analuhaas/ext-board/figures/image21.png

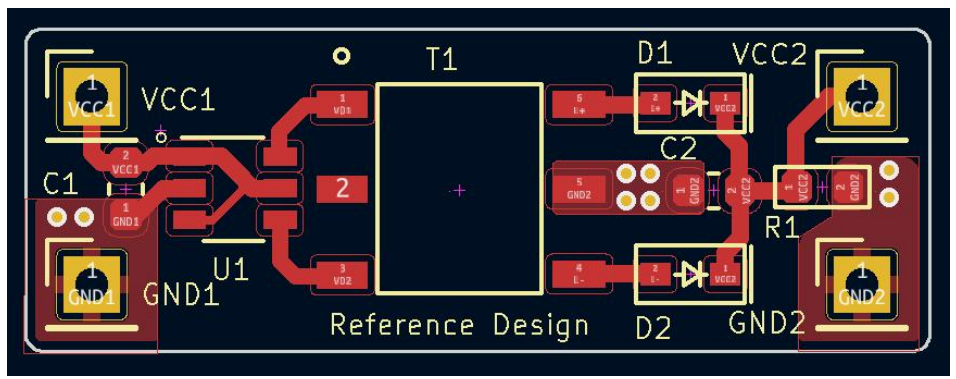
figures/image21.png
