analuhaas/ext-board/figures/image6.png

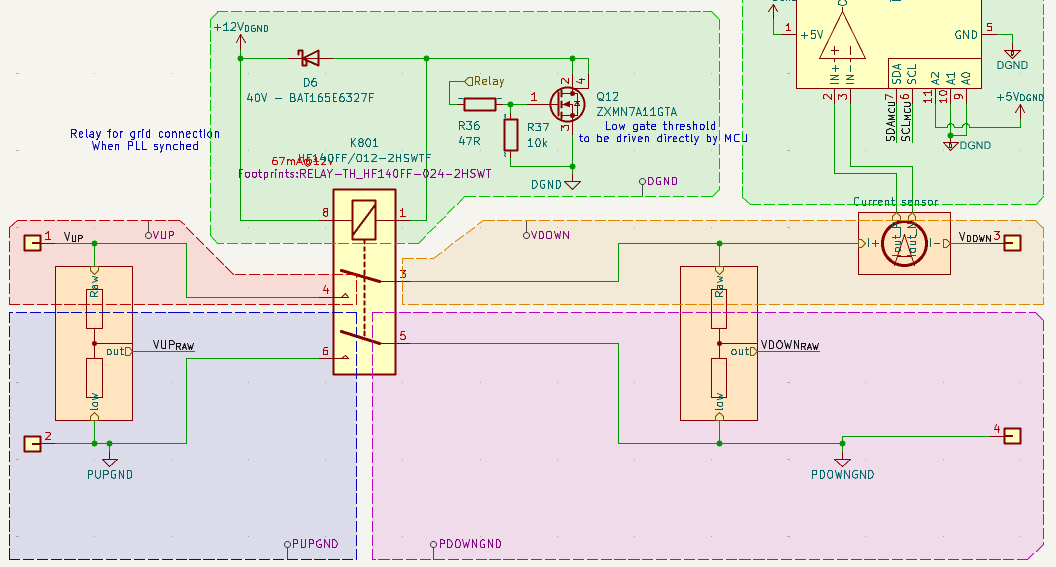
figures/image6.png
