analuhaas/ext-board/figures/image7.png

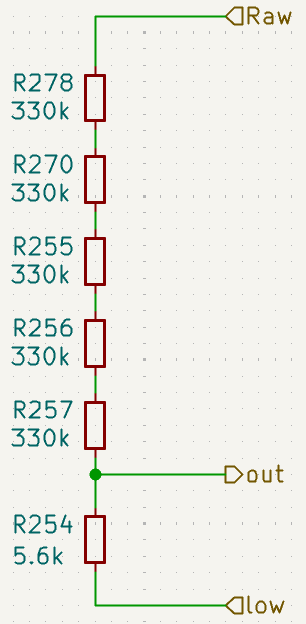
figures/image7.png
