analuhaas/ext-board/figures/image10.png

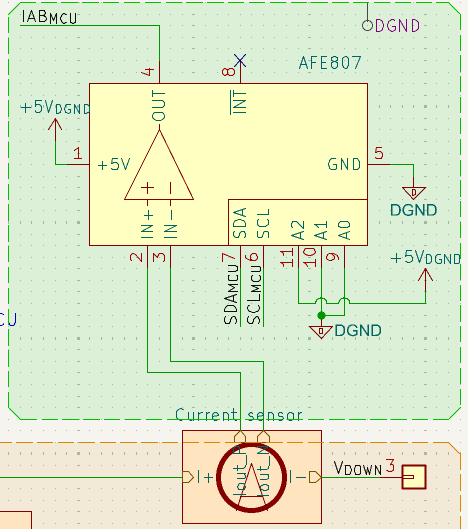
figures/image10.png
