analuhaas/ext-board/figures/image12.png

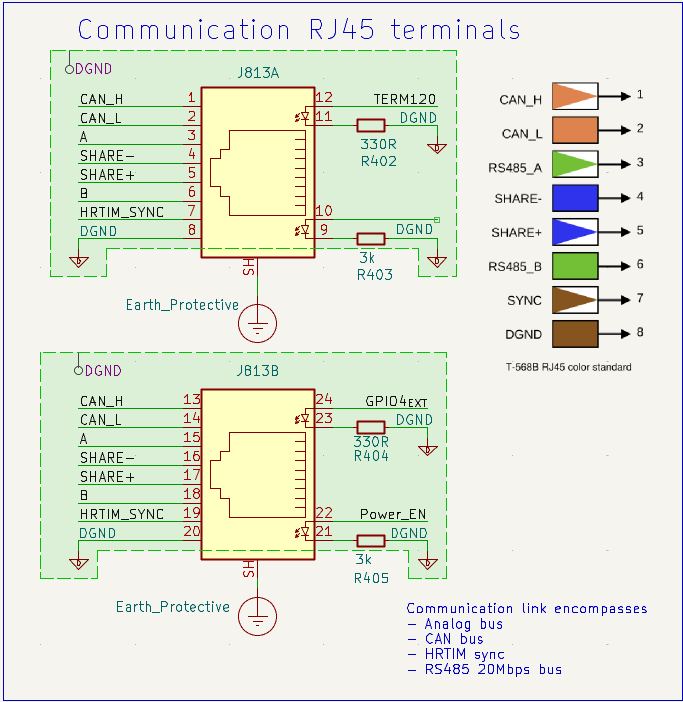
figures/image12.png
