analuhaas/ext-board/figures/image16.png

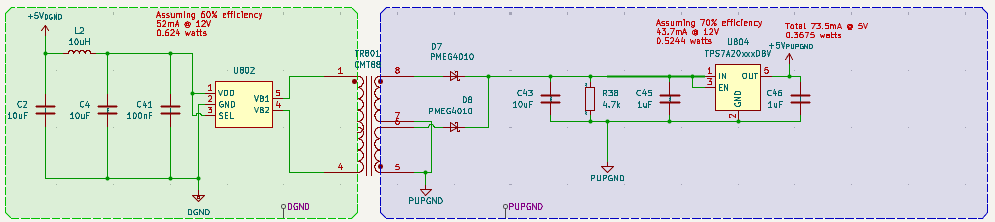
figures/image16.png
