analuhaas/ext-board/figures/image19.png

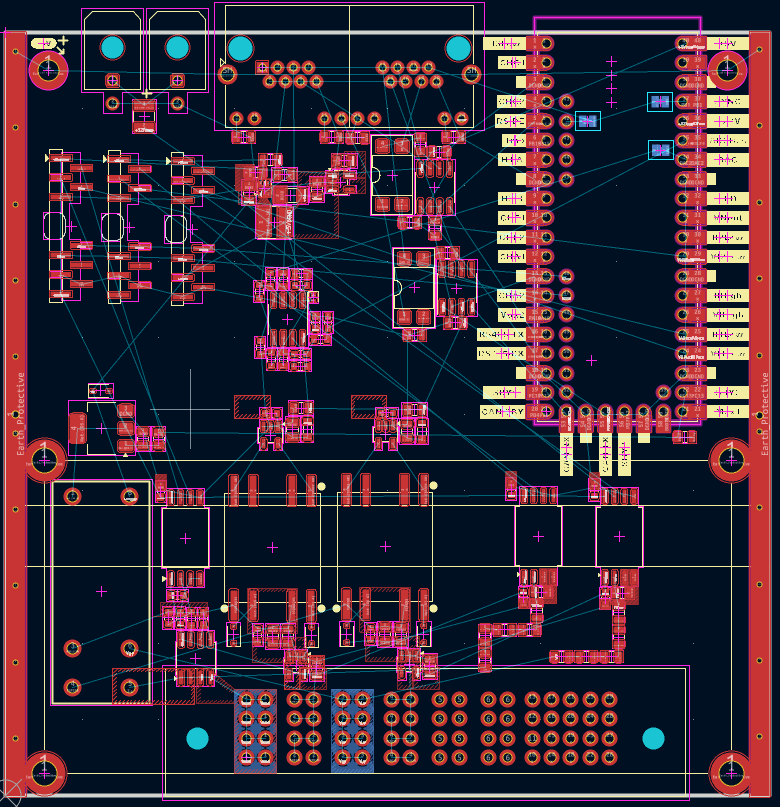
figures/image19.png
