analuhaas/ext-board/figures/image20.png

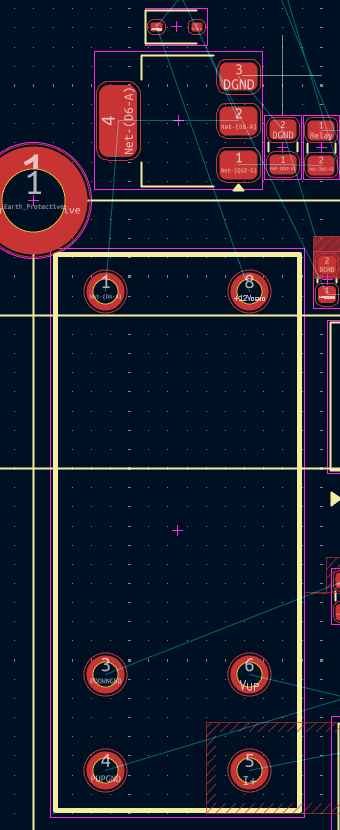
figures/image20.png
