analuhaas/ext-board/figures/image22.png

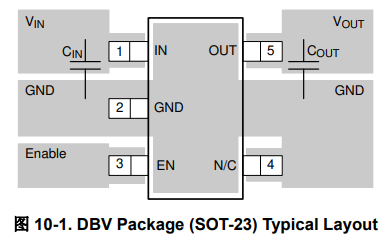
figures/image22.png
