analuhaas/ext-board/figures/image24.png

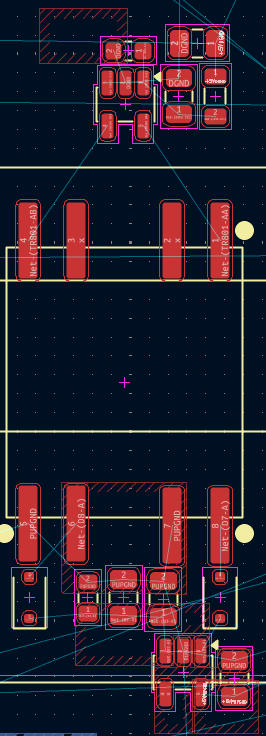
figures/image24.png
