analuhaas/ext-board/figures/image26.png

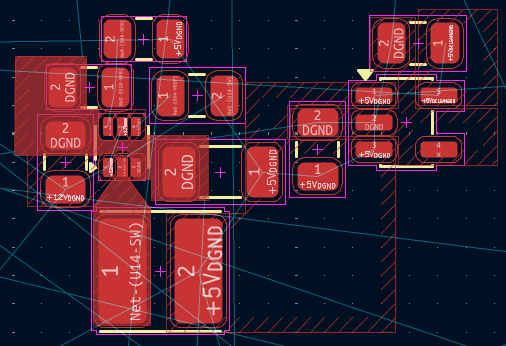
figures/image26.png
