analuhaas/ext-board/figures/image27.png

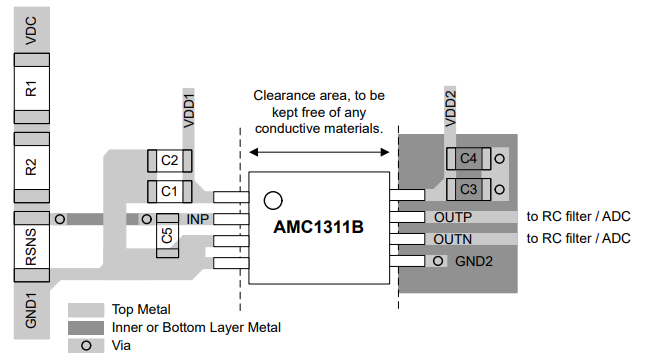
figures/image27.png
