analuhaas/ext-board/figures/image28.png

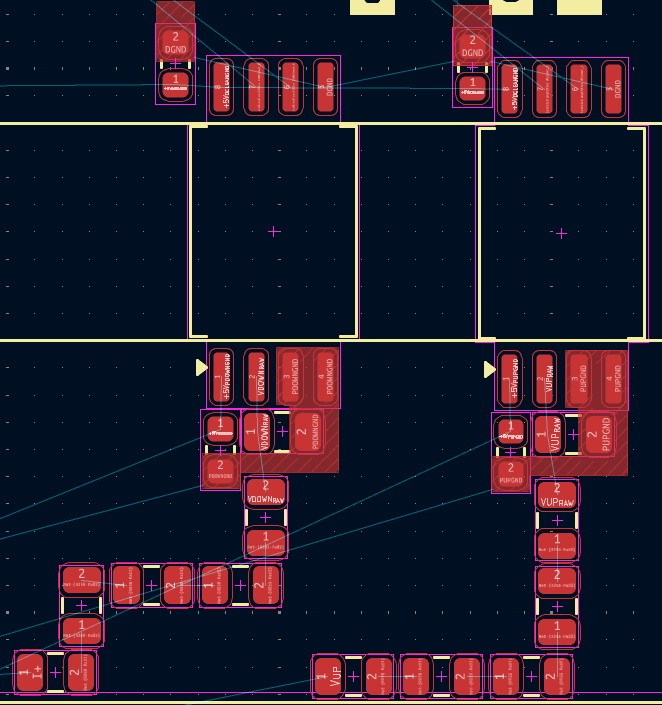
figures/image28.png
