analuhaas/ext-board/figures/image29.png

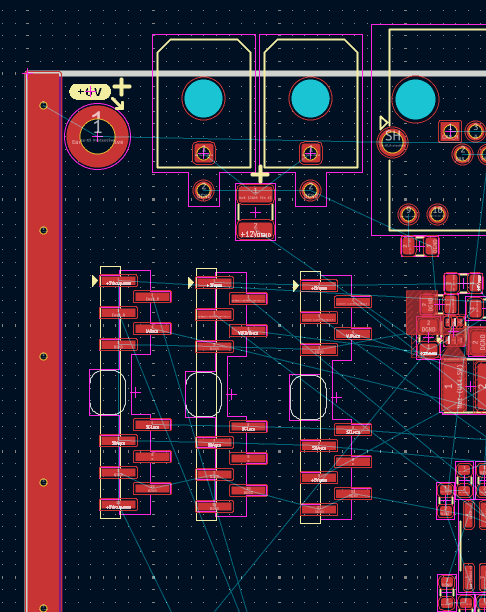
figures/image29.png
