analuhaas/ext-board/figures/image210.png

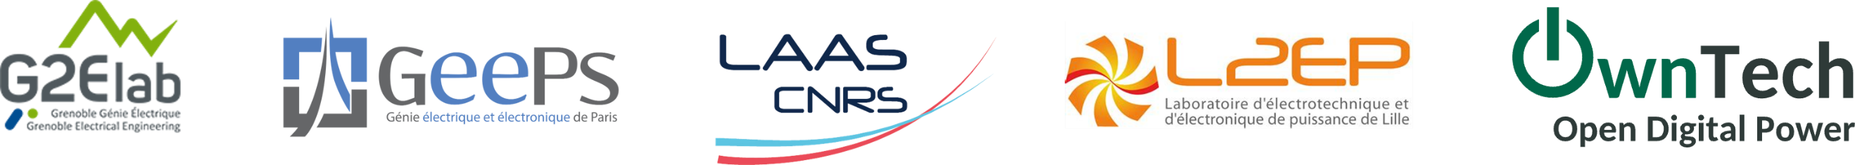
figures/image210.png
