analuhaas/ext-board/Schematic_Netlist_BOM/ext_board.csv

Reference | Value | Footprint | LCSC
C2,C3,C4,C5,C43,C44,C51 | 10uF | Capacitor_SMD:C_0805_2012Metric | C440198
C41,C42,C205,C206,C211,C212,C233,C234,C401,C410,C413,C492 | 100nF | Capacitor_SMD:C_0603_1608Metric | C14663
C45,C46,C47,C48,C49,C50 | 1uF | Capacitor_SMD:C_0805_2012Metric | C426085
C52 | 100nF | Capacitor_SMD:C_0805_2012Metric | C49678
C53 | 47uF | Capacitor_SMD:C_1206_3216Metric | C96123
C411,C412 | 20pF | Capacitor_SMD:C_0603_1608Metric | C1648
C470 | 10nF | Capacitor_SMD:C_0603_1608Metric | C1589
C493 | 1nF | Capacitor_SMD:C_0603_1608Metric | C1588
D6 | 40V - BAT165E6327F | Diode_SMD:D_SOD-323 | C42411276
D7,D8,D9,D10 | PMEG4010ESBYL | Diode_SMD:D_SOD-882 | C478156
D403 | BAS40DB | Diode_SMD:D_SOD-882 | C3000407
F402 | SMD1210-035-16V | Fuse:Fuse_1210_3225Metric | C70092
J405,J406 | HC-MX3.0-2*1AW | Footprints:Molex_Micro-Fit_3.0_43045-0200_2x01_P3.00mm_Horizontal | C3294382
J813 | RJ45_LED_Shielded_x2 | Footprints:RJ45_Amphenol_RJHSE538X-02 | C2902697
J819,J820,J821 |  | Footprints:PinSocket_1x05_P1.27mm_Vertical_SMD_Pin1Left | C46061714
J825,J826,J827 |  | Footprints:PinSocket_1x06_P1.27mm_Vertical_SMD_Pin1Right | C46061715
K801 | HF140FF/012-2HSWTF | Footprints:RELAY-TH_HF140FF-024-2HSWT | C5322766
L2,L3 | 10uH | Inductor_SMD:L_0805_2012Metric | C88173
L5 | 4.7uH - 80mR | Inductor_SMD:L_Cenker_CKCS4020 | C3002596
Q12 | ZXMN7A11GTA | Package_TO_SOT_SMD:SOT-223 | C460277
R36 | 47R | Resistor_SMD:R_0805_2012Metric | C17714
R37 | 10k | Resistor_SMD:R_0805_2012Metric | C17414
R38,R58,R412,R413,R414,R415,R416,R417,R418,R419,R428,R431,R432 | 4.7k | Resistor_SMD:R_0603_1608Metric | C23162
R55 | 120R | Footprints:R_0805_2012Metric | C17437
R56 | 56k | Footprints:R_0805_2012Metric | C17756
R57 | 10k | Footprints:R_0805_2012Metric | C17414
R249,R254 | 5.6k | Footprints:R_0805_2012Metric
R250,R251,R252,R255,R256,R257,R258,R269,R277,R278 | 330k | Footprints:R_0805_2012Metric | C17629
R259,R260,R261,R262,R279 | 330k | Resistor_SMD:R_1206_3216Metric | C104773
R280 | 15k | Resistor_SMD:R_0603_1608Metric | C22809
R281 | 10k | Resistor_SMD:R_0603_1608Metric | C25804
R401,R410,R470 | 120R | Resistor_SMD:R_0603_1608Metric | C22787
R402,R403,R404,R405 | 330R | Footprints:R_0805_2012Metric | C17630
R406,R407 | 680R | Resistor_SMD:R_0603_1608Metric | C23228
TR801,TR802 | CMT8830U | Footprints:CMT88F0U | C37648312
U14 | TPS562202 | Package_TO_SOT_SMD:SOT-563 | C2877547
U205,U207,U211 | AMC1311BDWVR | Package_SO:SOIC-8_7.5x5.85mm_P1.27mm | C783598
U402 | CA-IF1051S | Footprints:SOIC-8_3.9x4.9mm_P1.27mm | C5121951
U405 | CA-IF4850HS | Package_SO:SOIC-8_3.9x4.9mm_P1.27mm | C7422579
U406 | MCP6487T-E/SN | Package_SO:SOIC-8_3.9x4.9mm_P1.27mm | C5224810
U801 | ACS724LLCTR-50AB-T-JSM | Package_SO:SOIC-8_3.9x4.9mm_P1.27mm | C20606860
U802,U803 | CMP6503S | Package_TO_SOT_SMD:SOT-23-5 | C47117012
U804,U805,U806 | TPS7A20xxxDBV | Package_TO_SOT_SMD:SOT-23-5 | C2864504
U809 |  | Footprints:PwrBlade51722-106020
U820,U821 | GAQY221S | Package_SO:SOP-4_3.8x4.1mm_P2.54mm | C7435105
