analuhaas/ext-board/figures/image_wiring_Dfeed.png

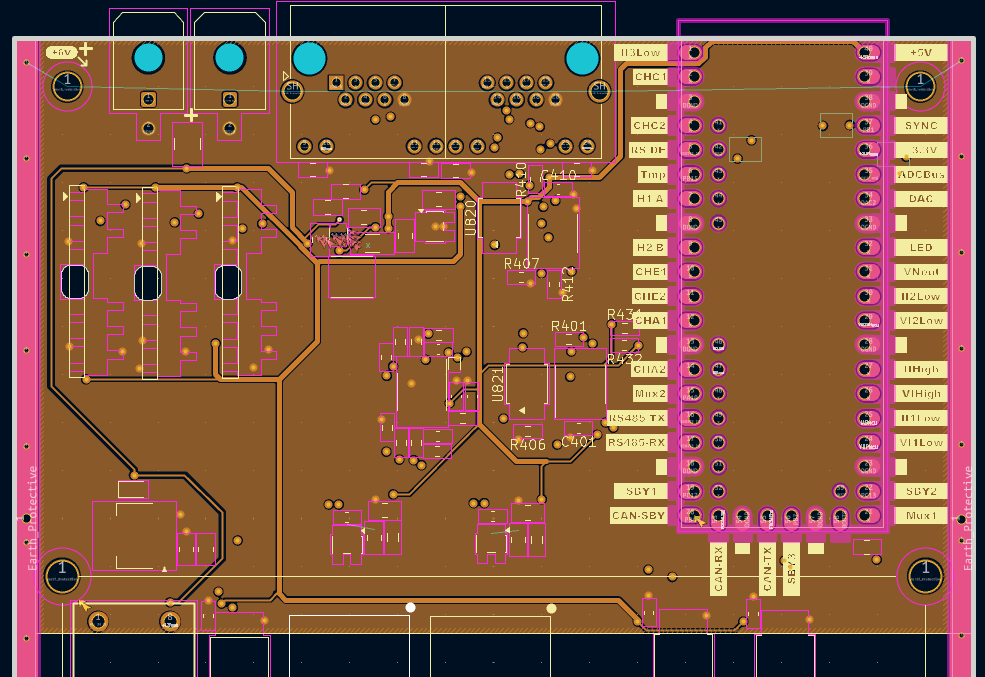
figures/image_wiring_Dfeed.png
