analuhaas/ext-board/figures/image_wiring_IsensorRelay.png

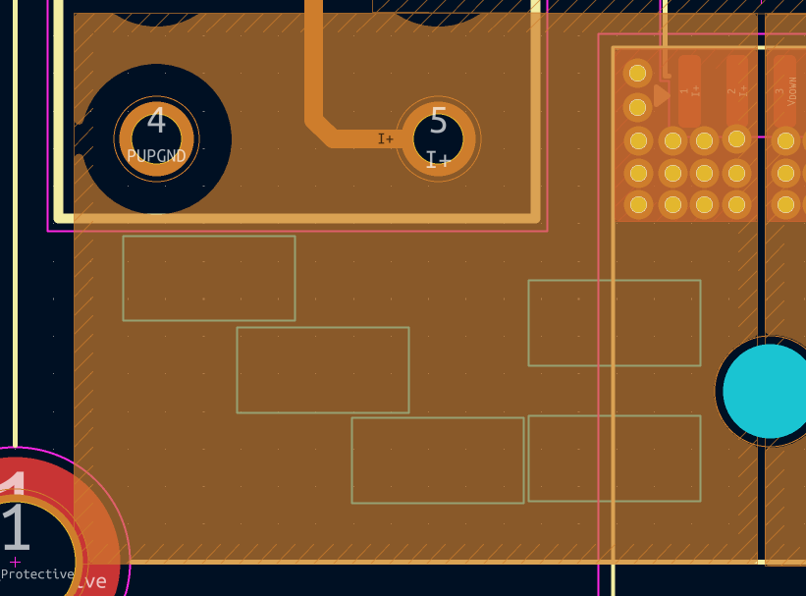
figures/image_wiring_IsensorRelay.png
