analuhaas/ext-board/figures/image_wiring_Pcircuit.png

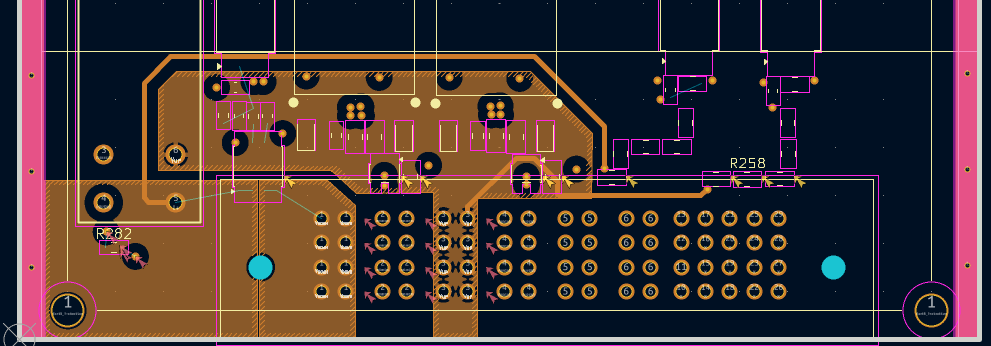
figures/image_wiring_Pcircuit.png
