analuhaas/ext-board/figures/image_wiring_Pfeed.png

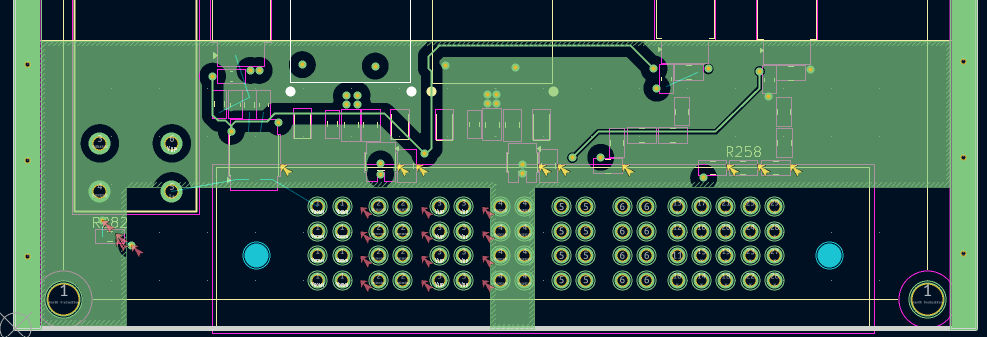
figures/image_wiring_Pfeed.png
