analuhaas/ext-board/Schematic_Netlist_BOM/ext_board.pdf

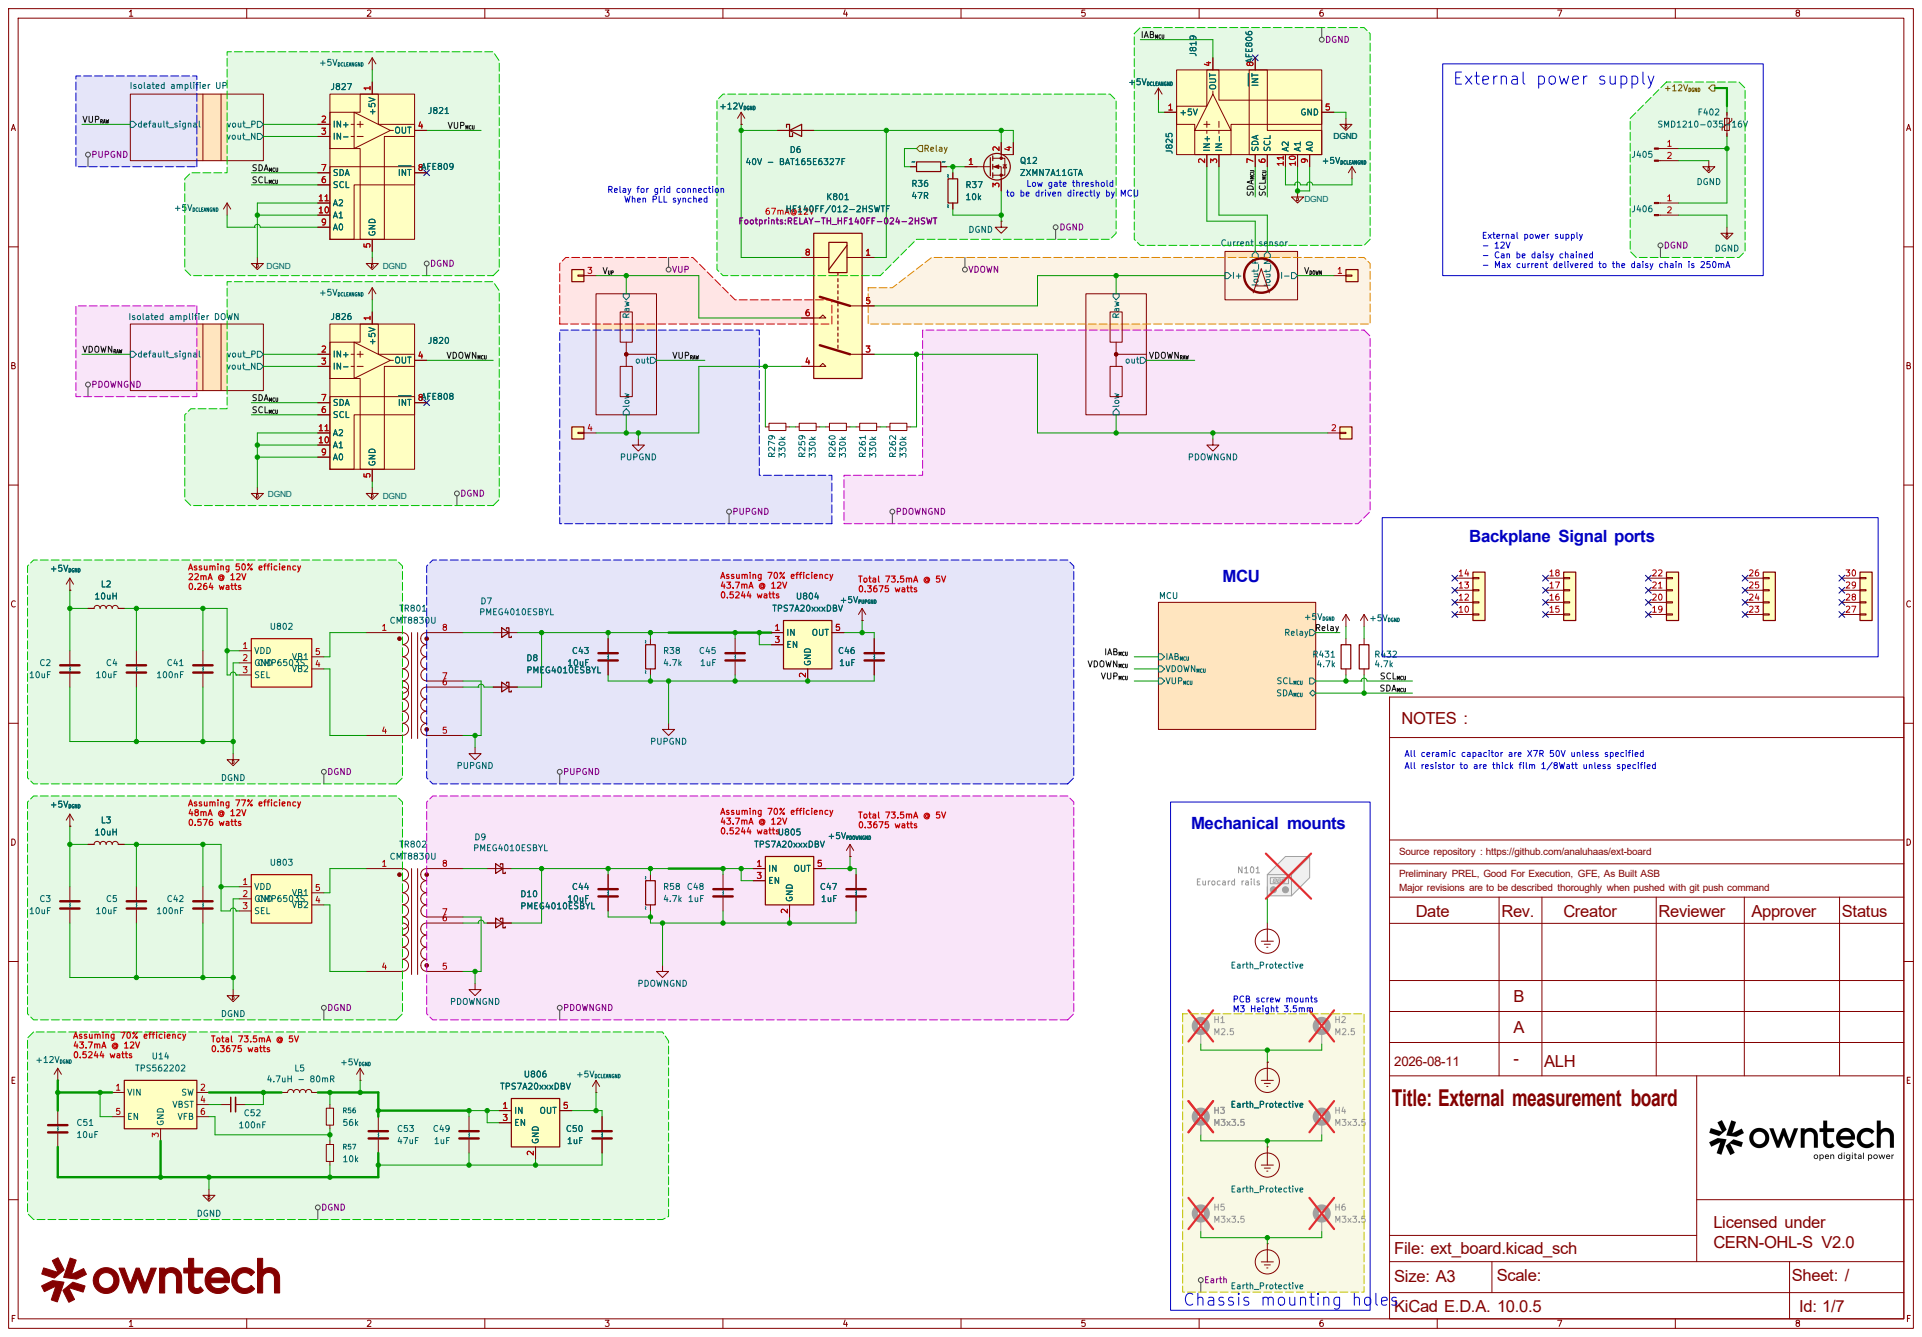
[picture p20: page 1]

3 OUT 4 GND 5 J825 SCL 6 SDA 7 INT 8 A0

Low gate threshold
to be driven directly by MCU

Relay for grid connection When PLL synched

Source repository : https://github.com/analuhaas/ext-board low out Raw

IABMCU VDOWNMCU VUPMCU MCU

All ceramic capacitor are X7R 50V unless specified U806

All resistor to are thick film 1/8Watt unless specified
Earth_Protective Earth_Protective N101

Major revisions are to be described thoroughly when pushed with git push command Preliminary PREL, Good For Execution, GFE, As Built ASB

Earth_Protective

2026-08-11 | - | ALH

Title: External measurement board | Licensed under CERN-OHL-S V2.0

Size: A3 | Sheet: / | F Scale:
KiCad E.D.A. 10.0.5 | Id: 1/7

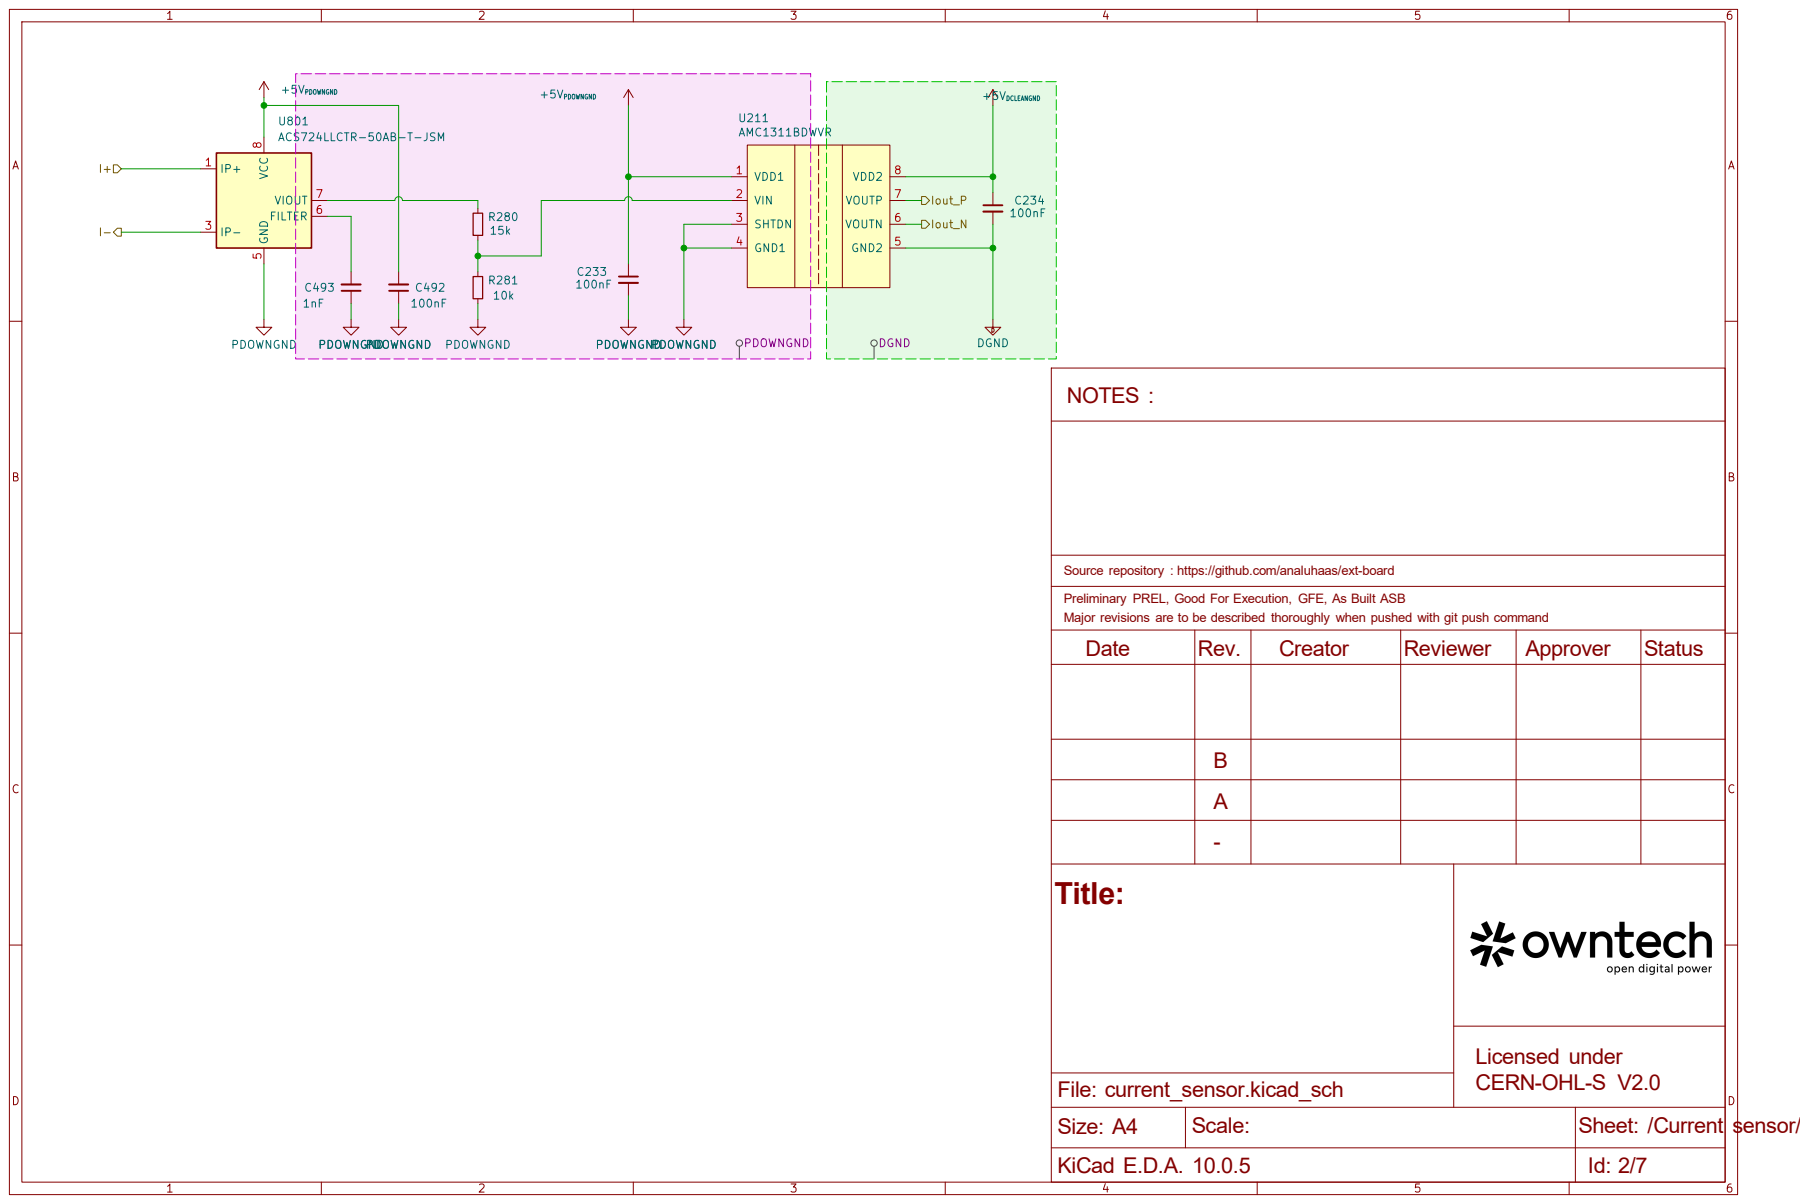
[picture p21: page 2]

Source repository : https://github.com/analuhaas/ext-board

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

Title:

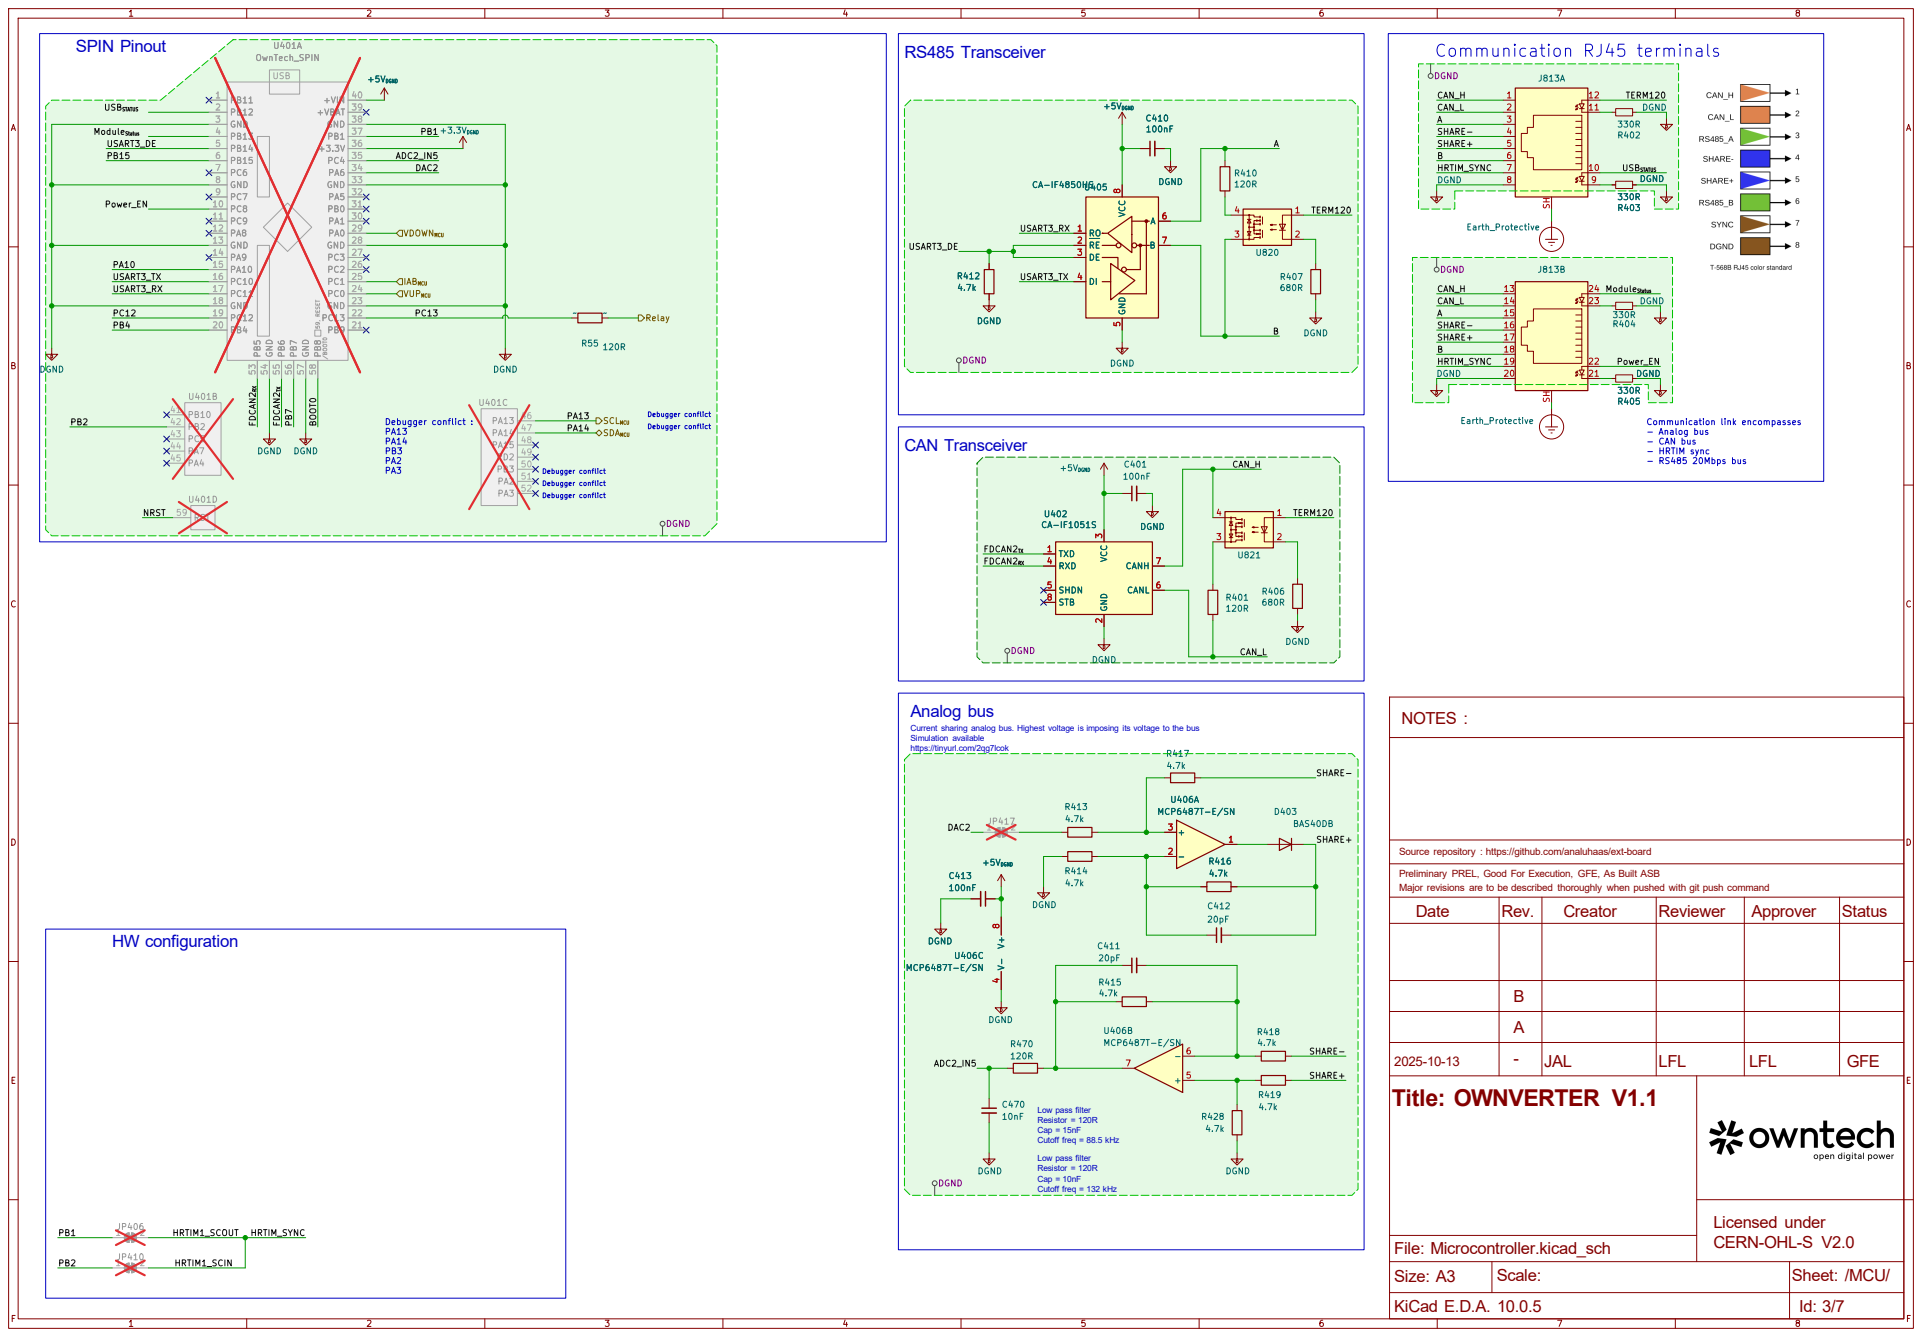
[picture p22: page 3]

Debugger conflict Debugger conflict HW configuration

Current sharing analog bus. Highest voltage is imposing its voltage to the bus Simulation available https://tinyurl.com/2qg7lcok

Source repository : https://github.com/analuhaas/ext-board R418

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

2025-10-13 | - | JAL | LFL | LFL | GFE

Title: OWNVERTER V1.1 | Licensed under CERN-OHL-S V2.0

Low pass filter Resistor = 120R

Cap = 10nF Cutoff freq = 132 kHz

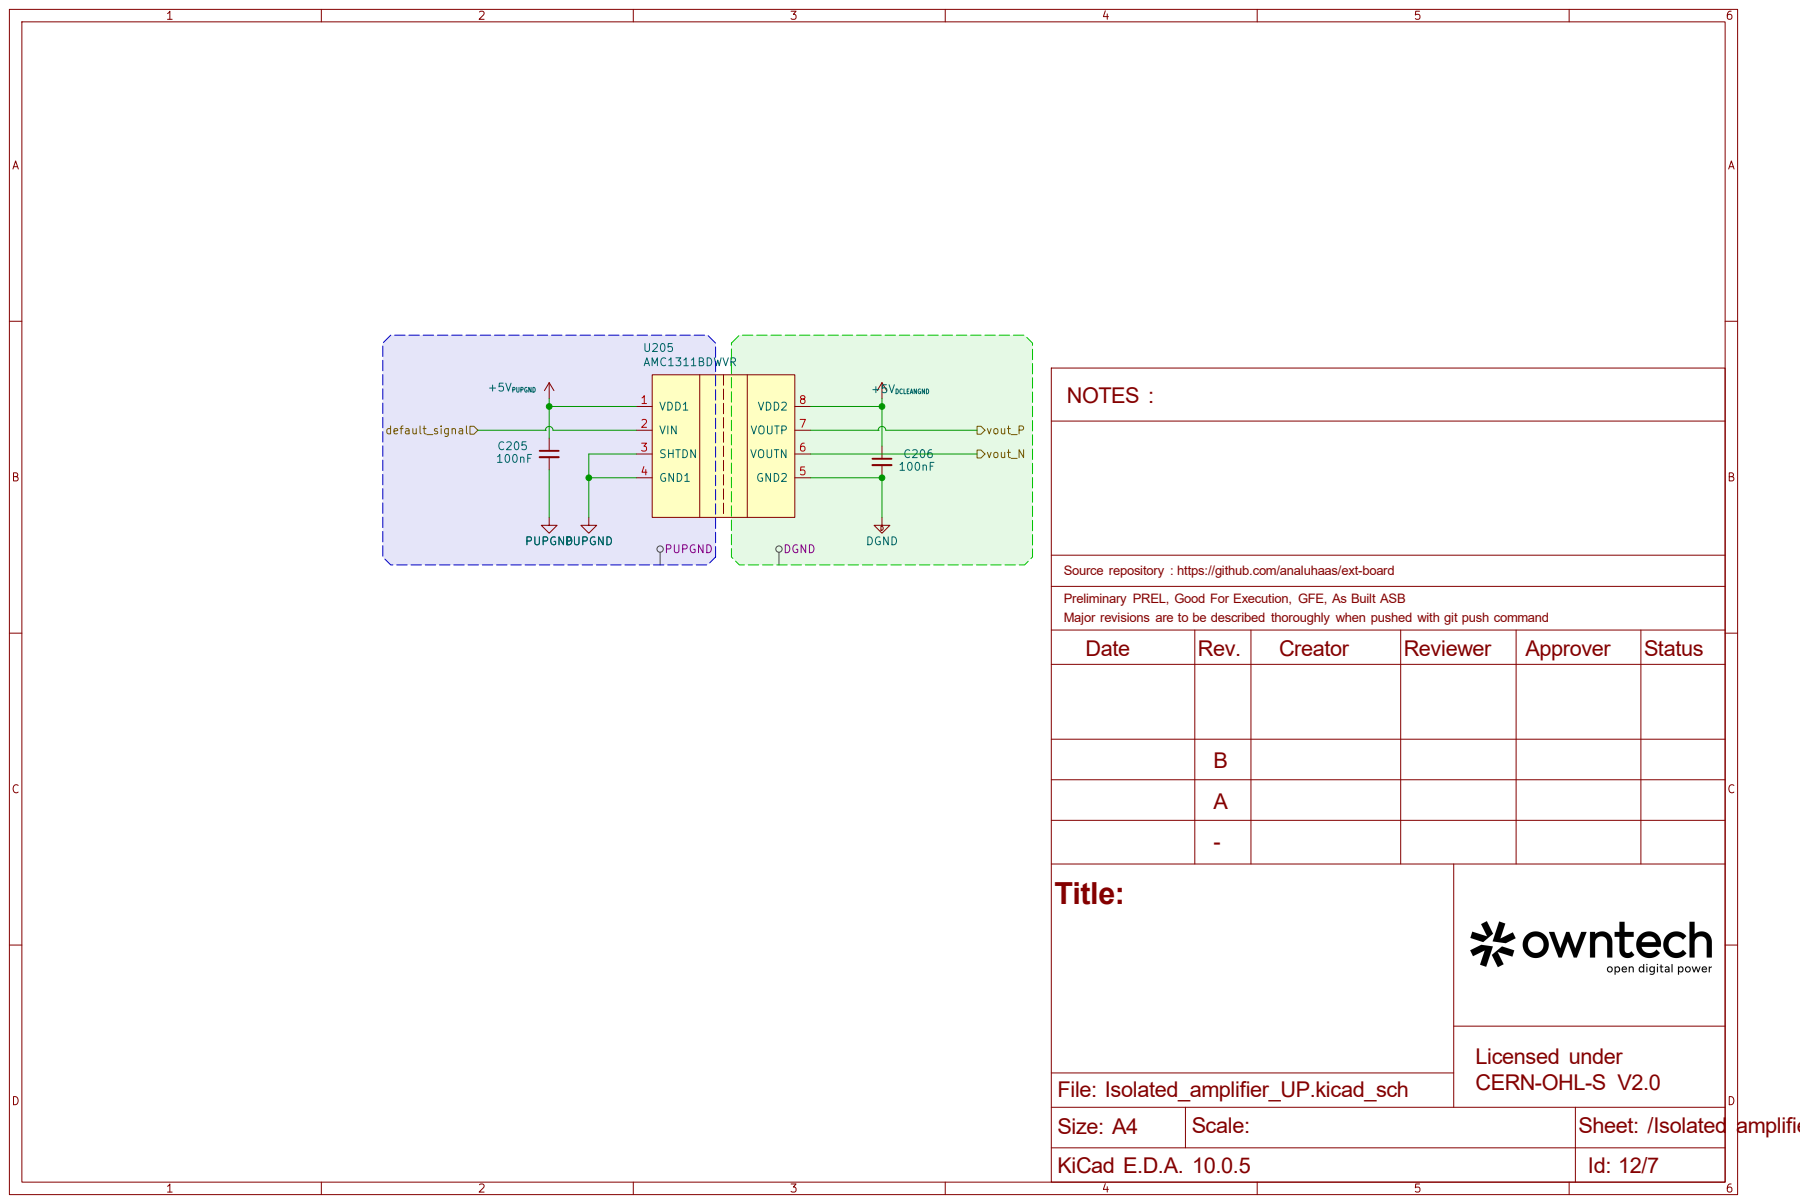
[picture p23: page 4]

VDD1 1 | VOUTP

VIN 2 | 7

Source repository : https://github.com/analuhaas/ext-board C206

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

Title:

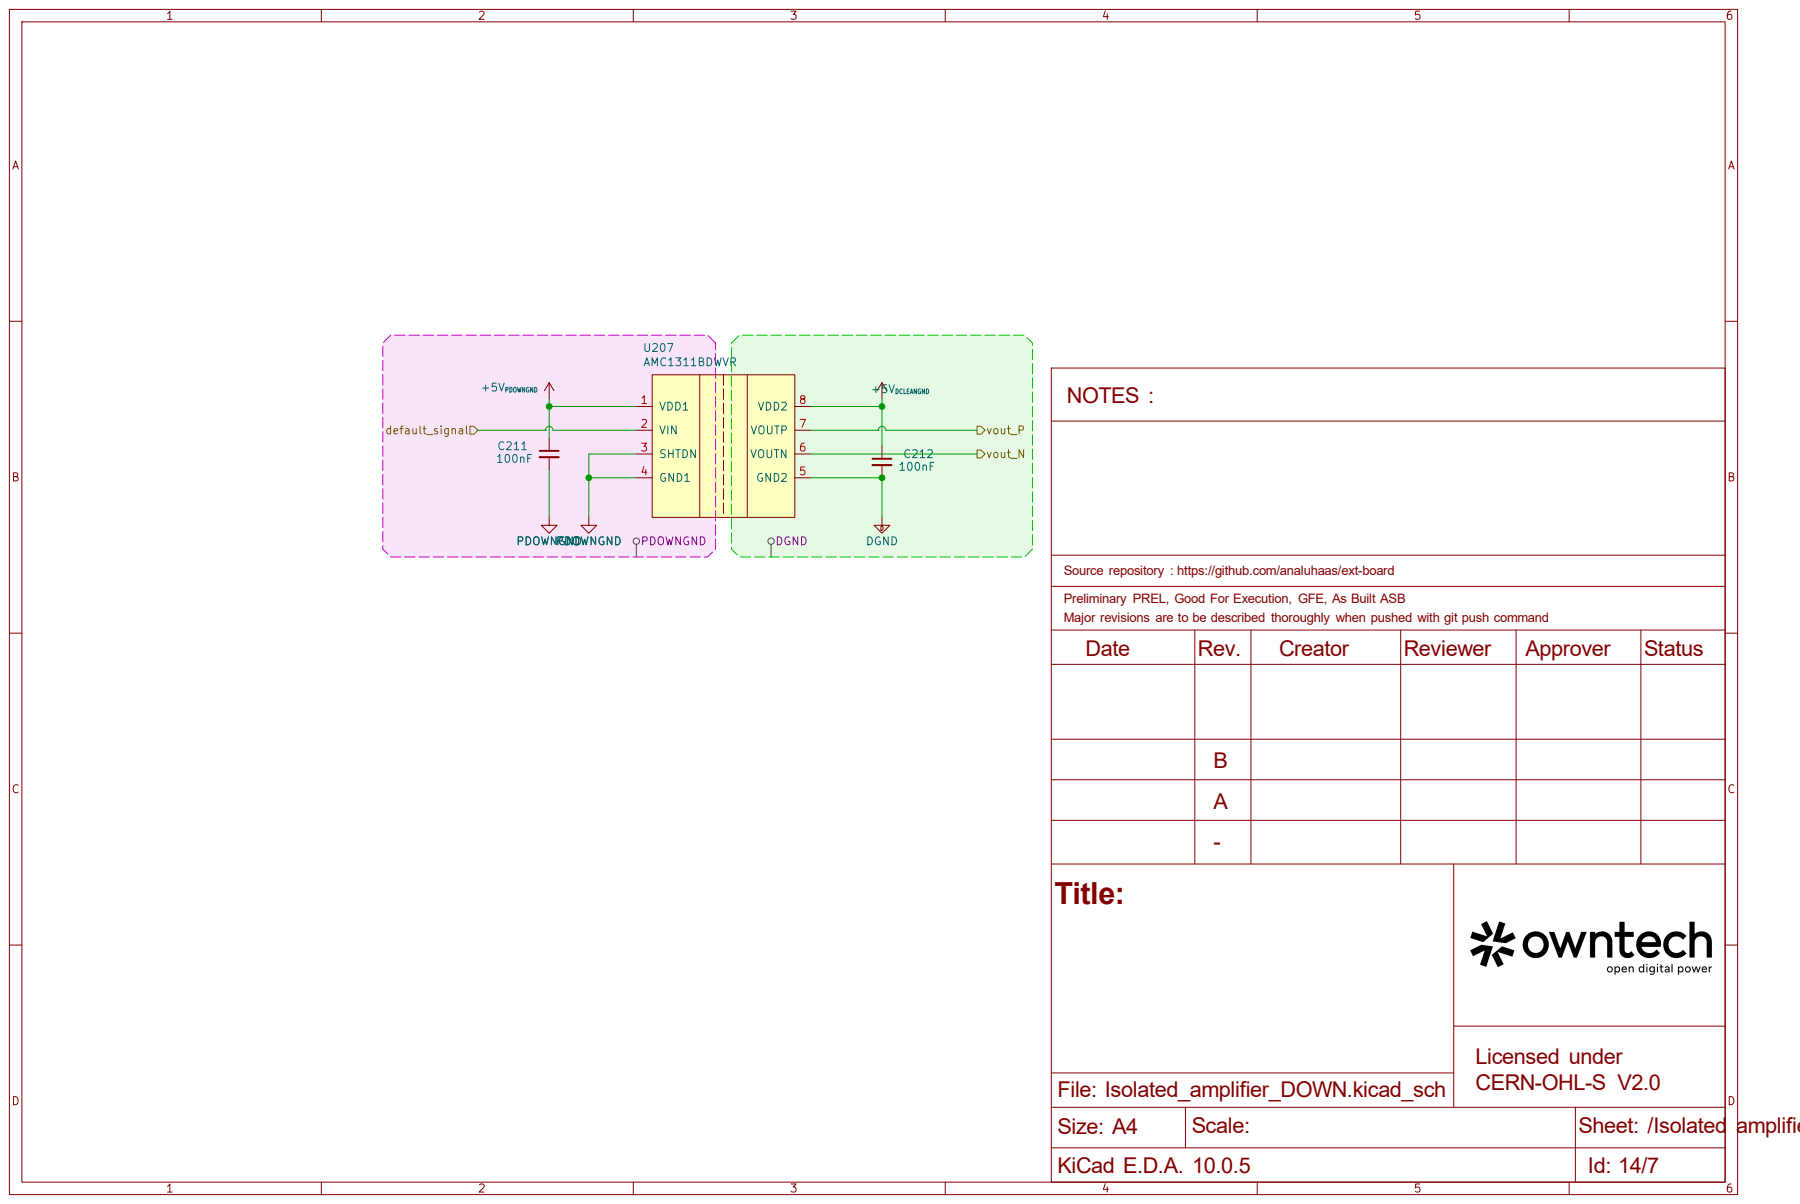
[picture p24: page 5]

VDD1 1 | VOUTP

VIN 2 | 7

Source repository : https://github.com/analuhaas/ext-board

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

Title:

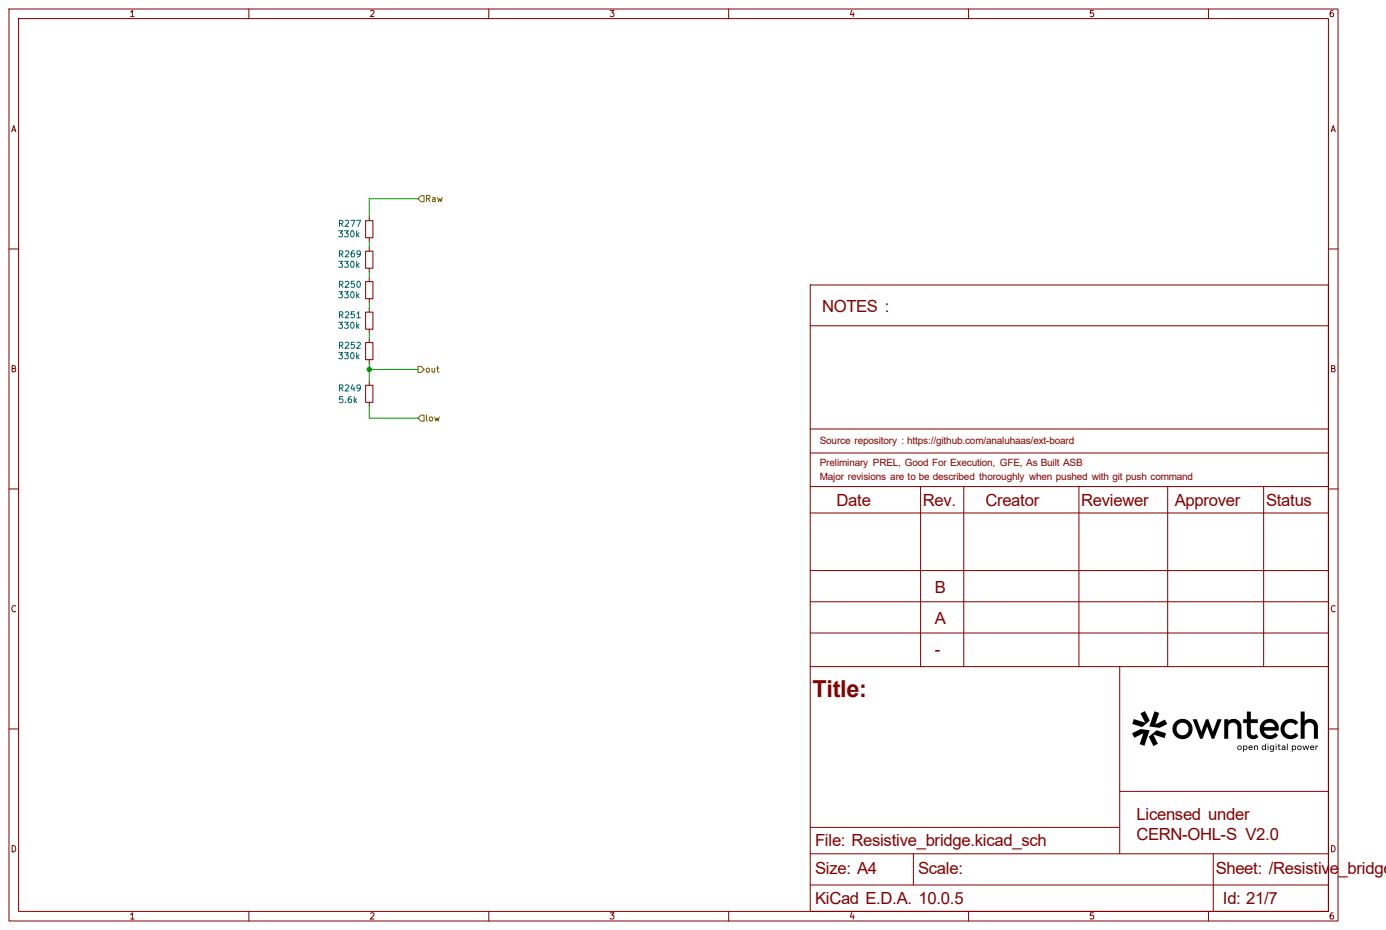
[picture p25: page 6]
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

Title:

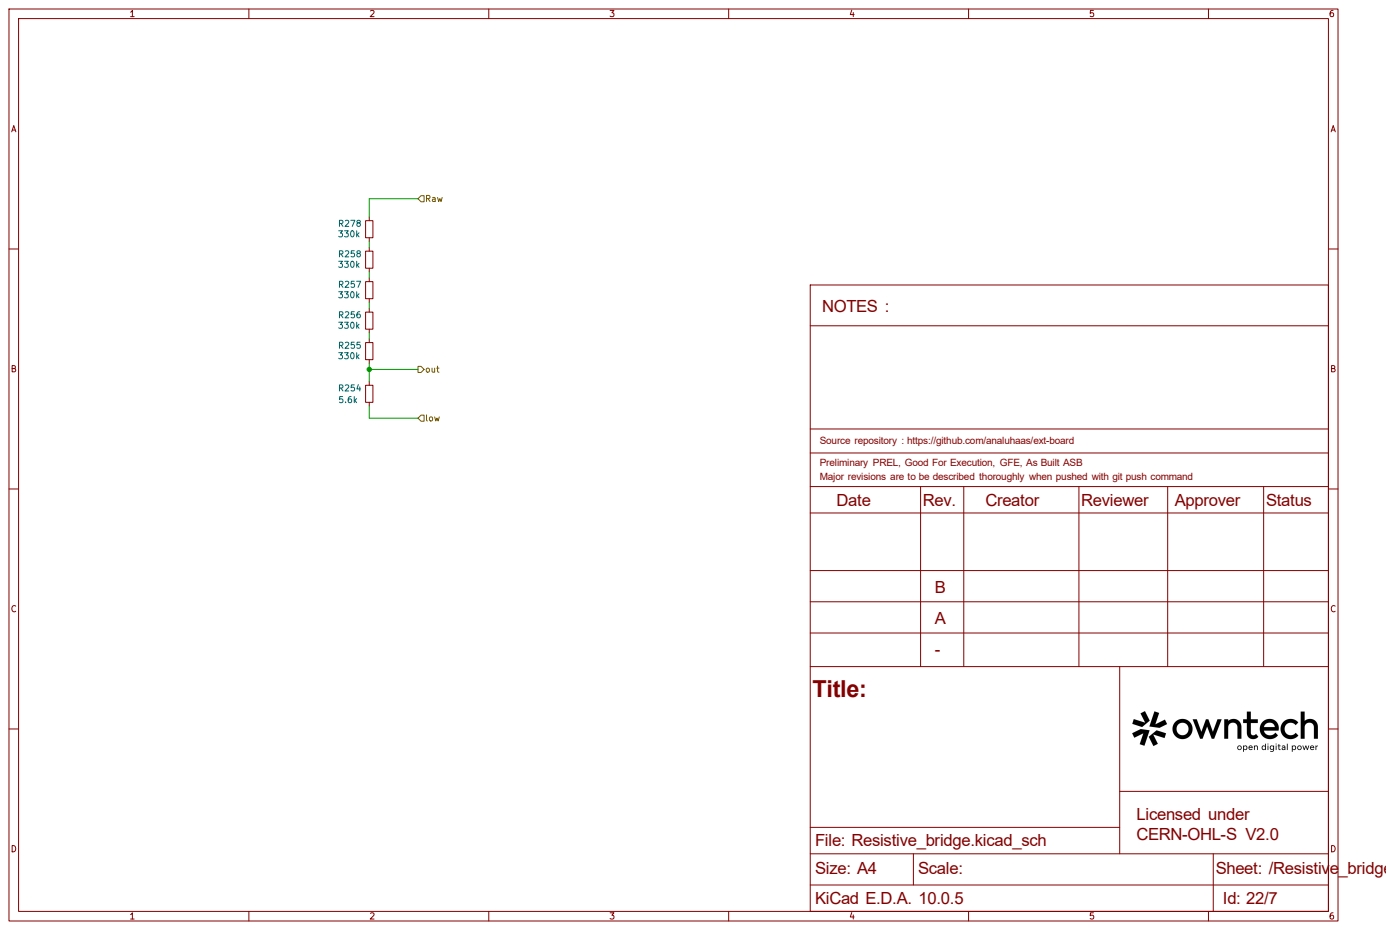
[picture p26: page 7]

Source repository : https://github.com/analuhaas/ext-board R257

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

Title:
