analuhaas/ext-board/ext_board.pdf

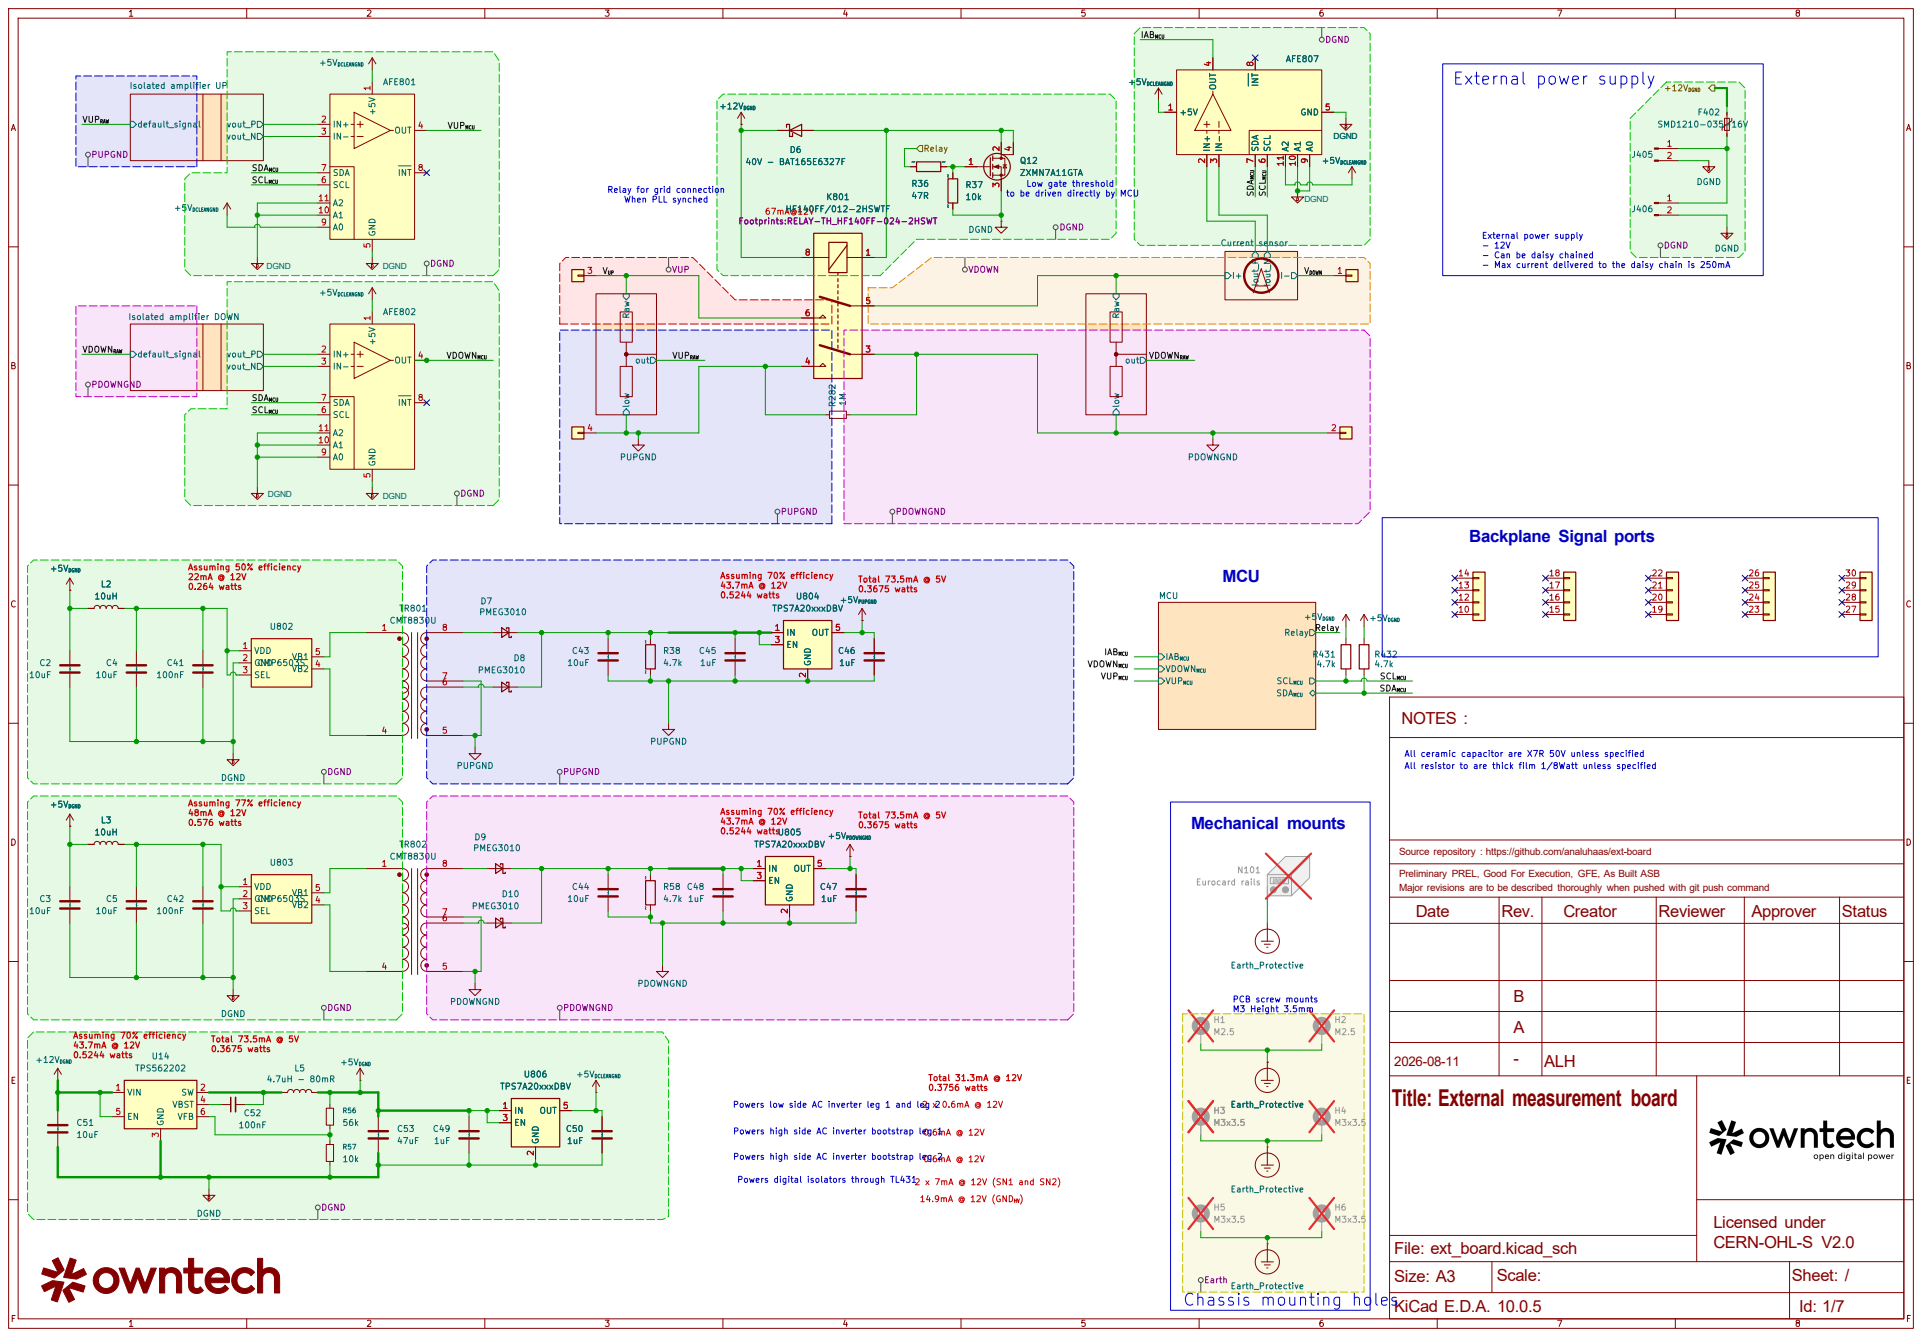
[picture p27: page 1]

3 OUT 4 GND 5 SCL 6 SDA 7 INT 8 A0

to be driven directly by MCU Relay for grid connection When PLL synched

External power supply - 12V - Can be daisy chained - Max current delivered to the daisy chain is 250mA

Source repository : https://github.com/analuhaas/ext-board low out Raw

Isolated amplifier DOWN
Total 73.5mA @ 5V 0.3675 watts Powers digital isolators through TL431

IABMCU VDOWNMCU VUPMCU MCU

All ceramic capacitor are X7R 50V unless specified
All resistor to are thick film 1/8Watt unless specified

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

2026-08-11 | - | ALH

Title: External measurement board | Licensed under CERN-OHL-S V2.0

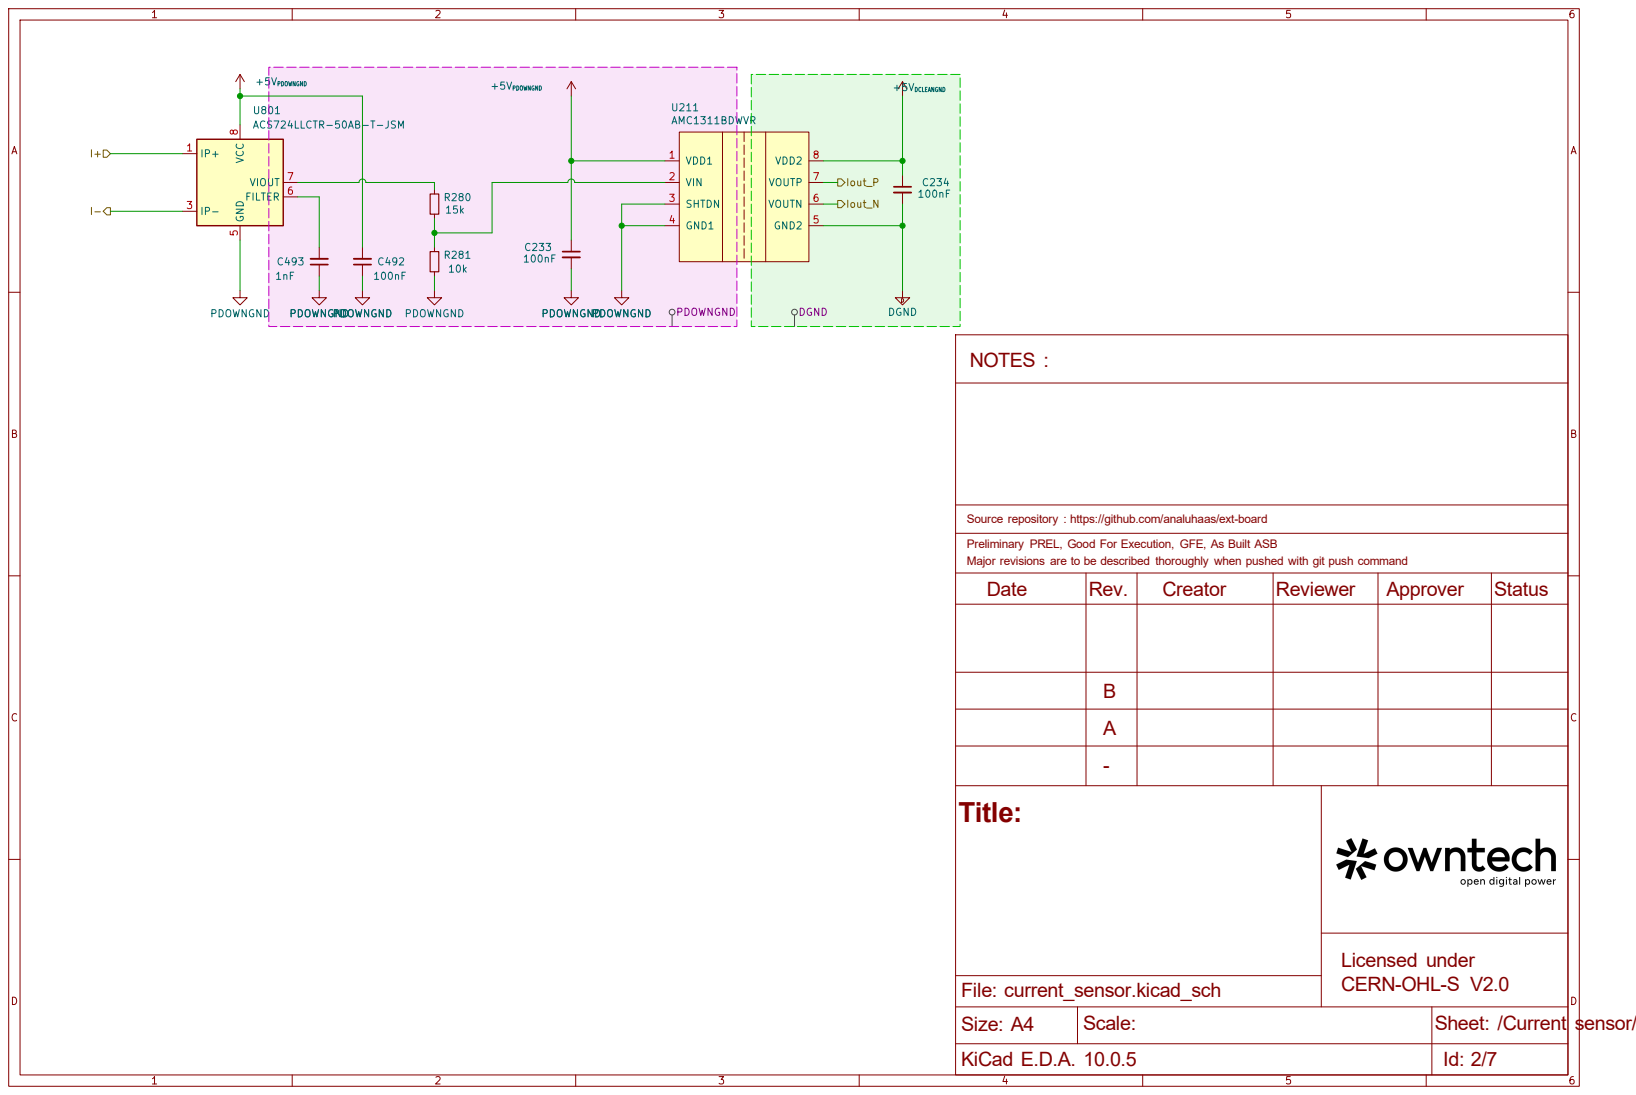
[picture p28: page 2]

Source repository : https://github.com/analuhaas/ext-board

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

Title:

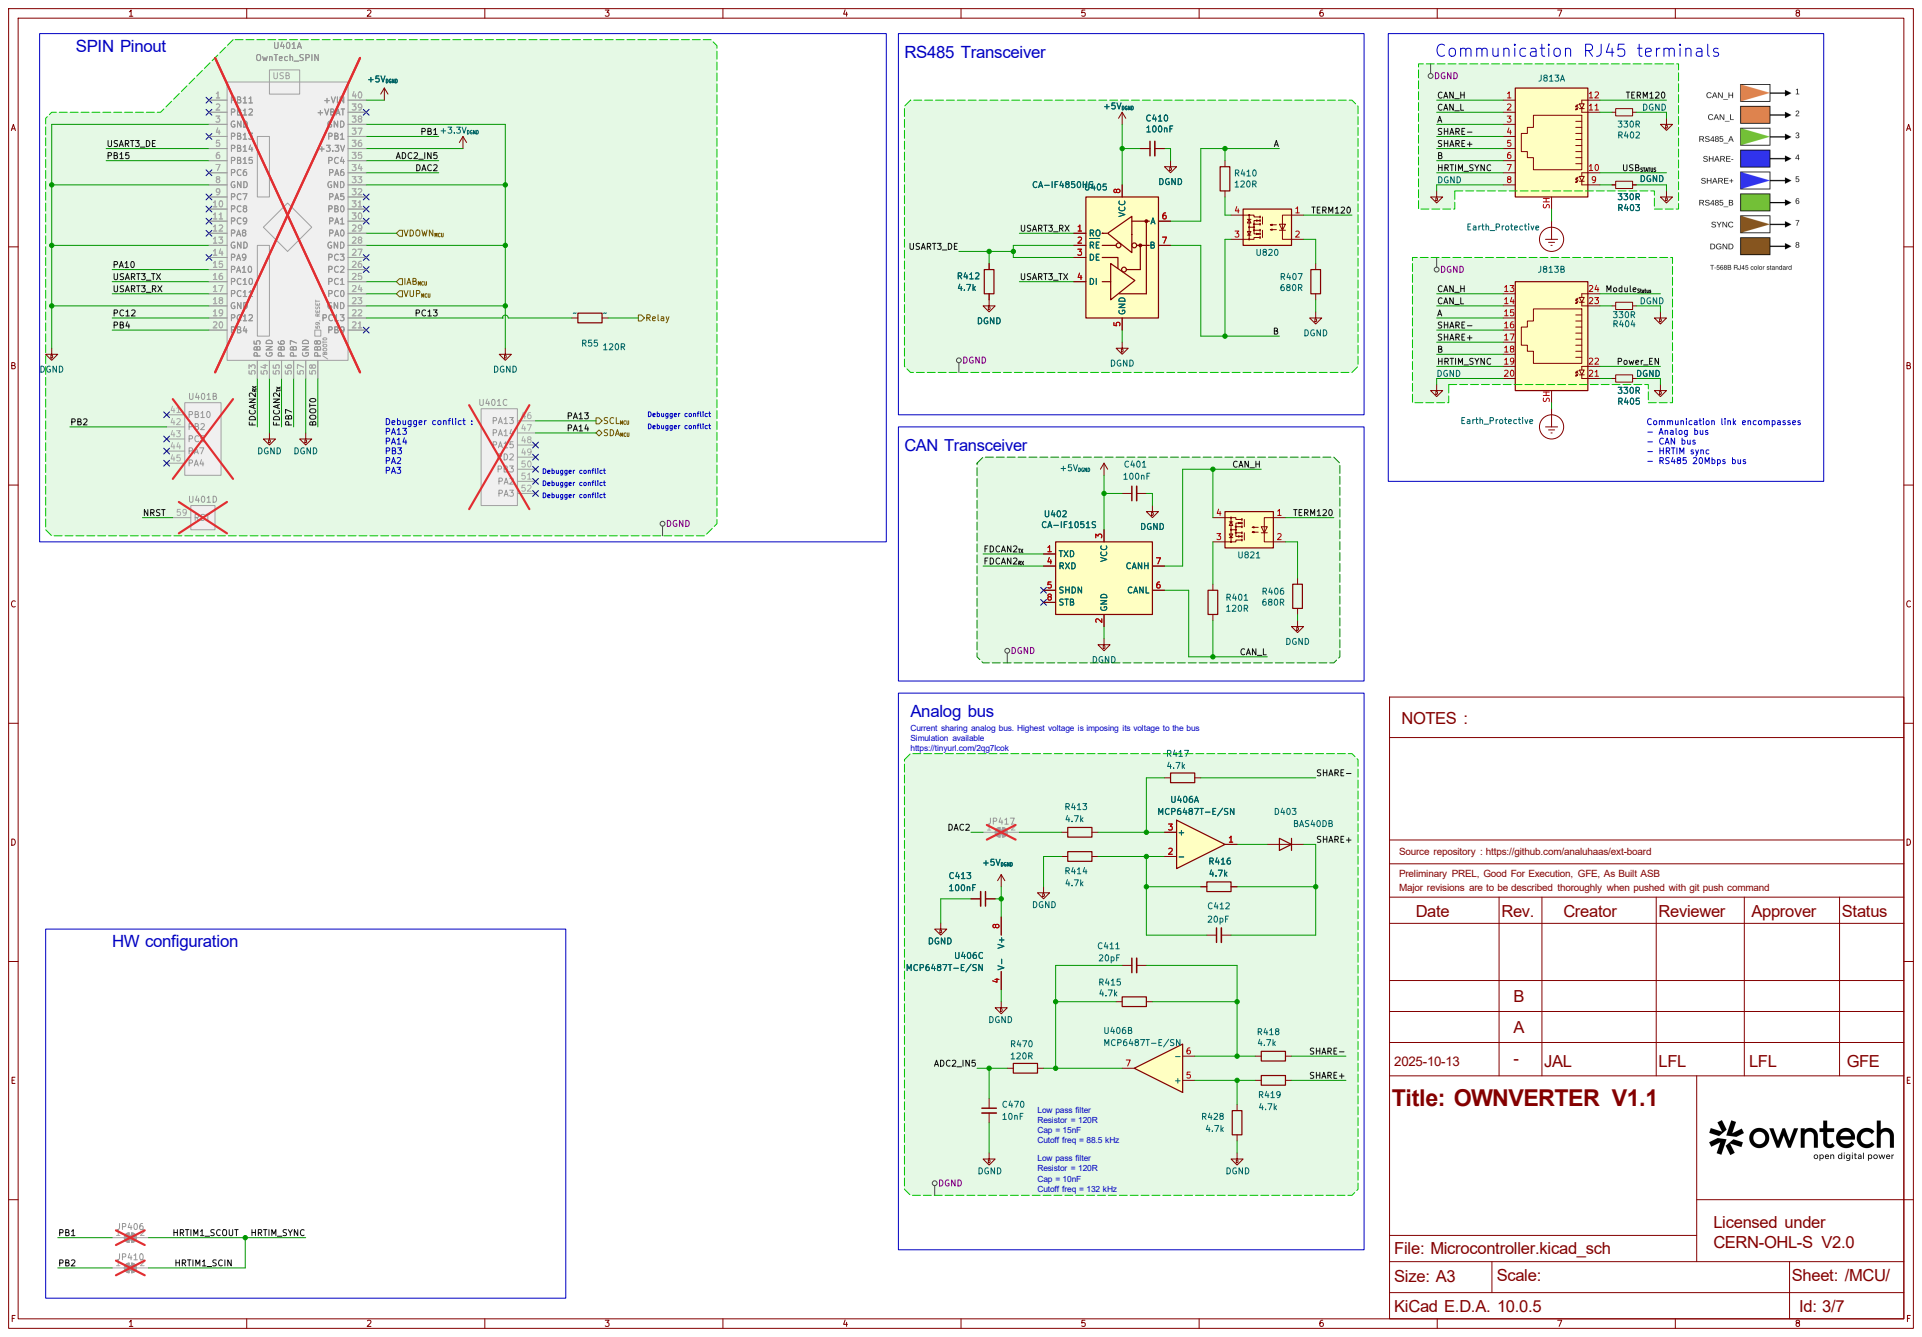
[picture p29: page 3]

Debugger conflict HW configuration

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

2025-10-13 | - | JAL | LFL | LFL | GFE

Title: OWNVERTER V1.1 | Licensed under CERN-OHL-S V2.0

Low pass filter Resistor = 120R

Cap = 15nF Cutoff freq = 88.5 kHz Low pass filter Resistor = 120R

Cap = 10nF Cutoff freq = 132 kHz

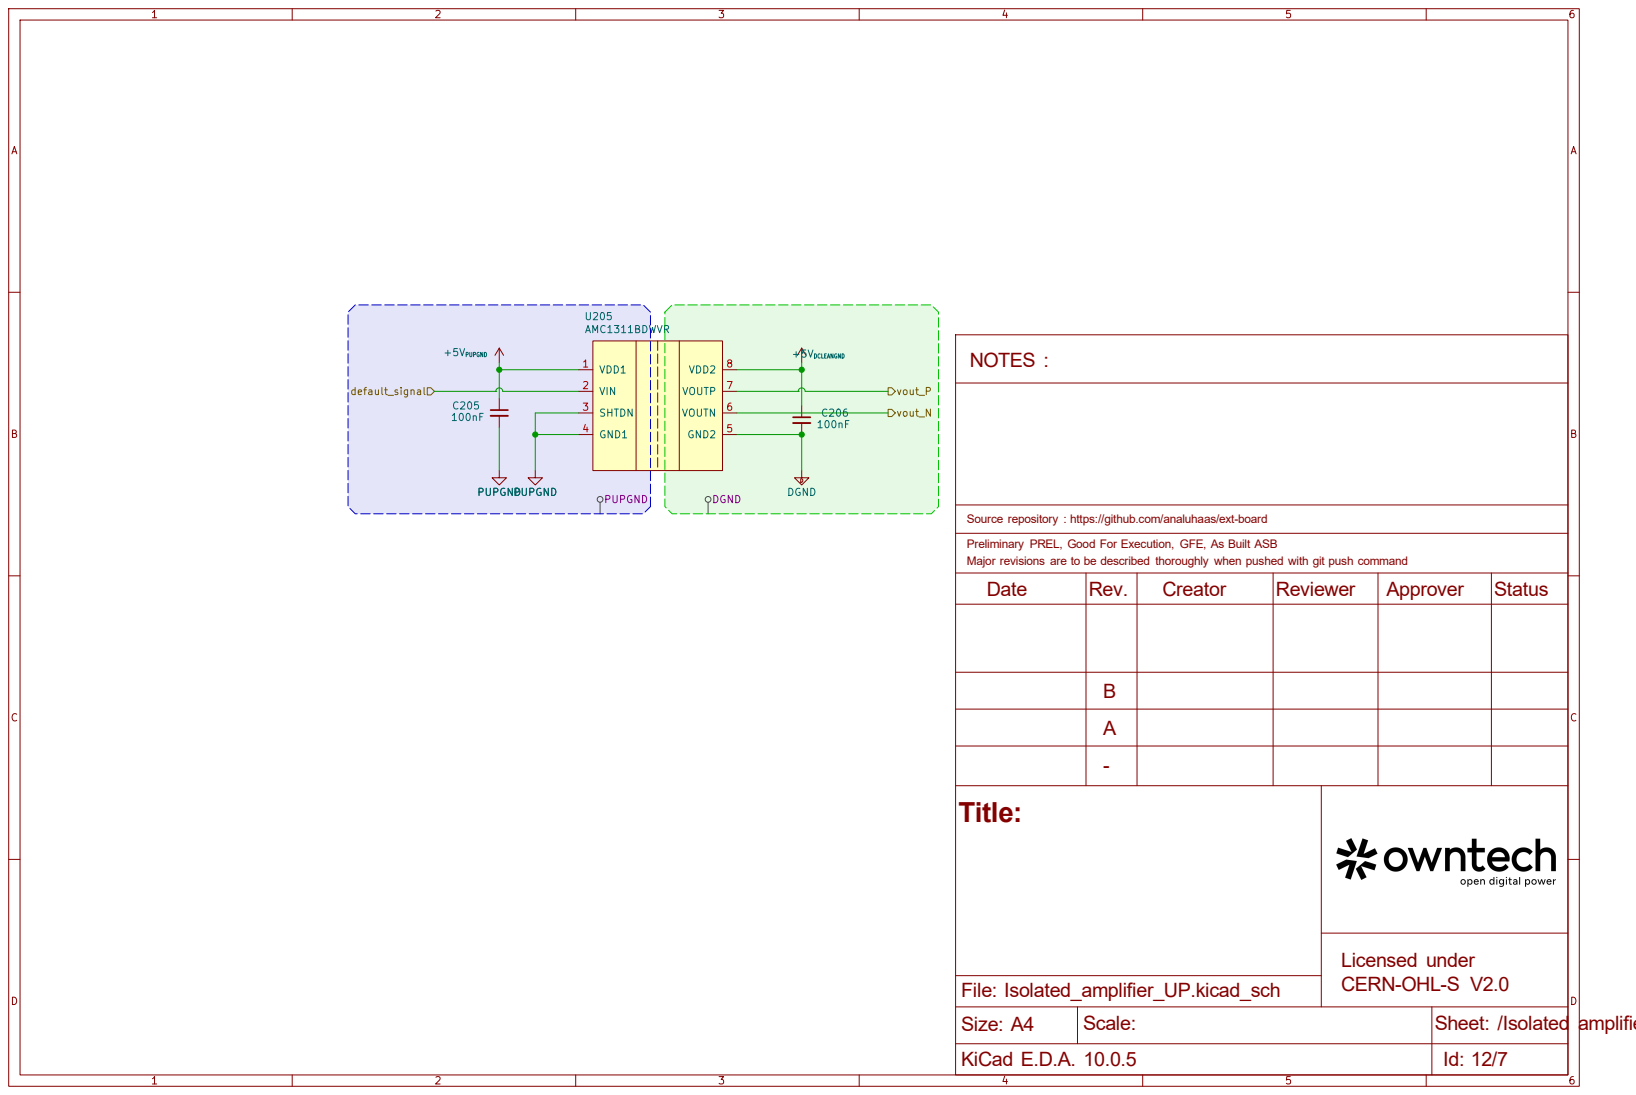
[picture p30: page 4]

Source repository : https://github.com/analuhaas/ext-board +5VDCLEANGND C206

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

Title:

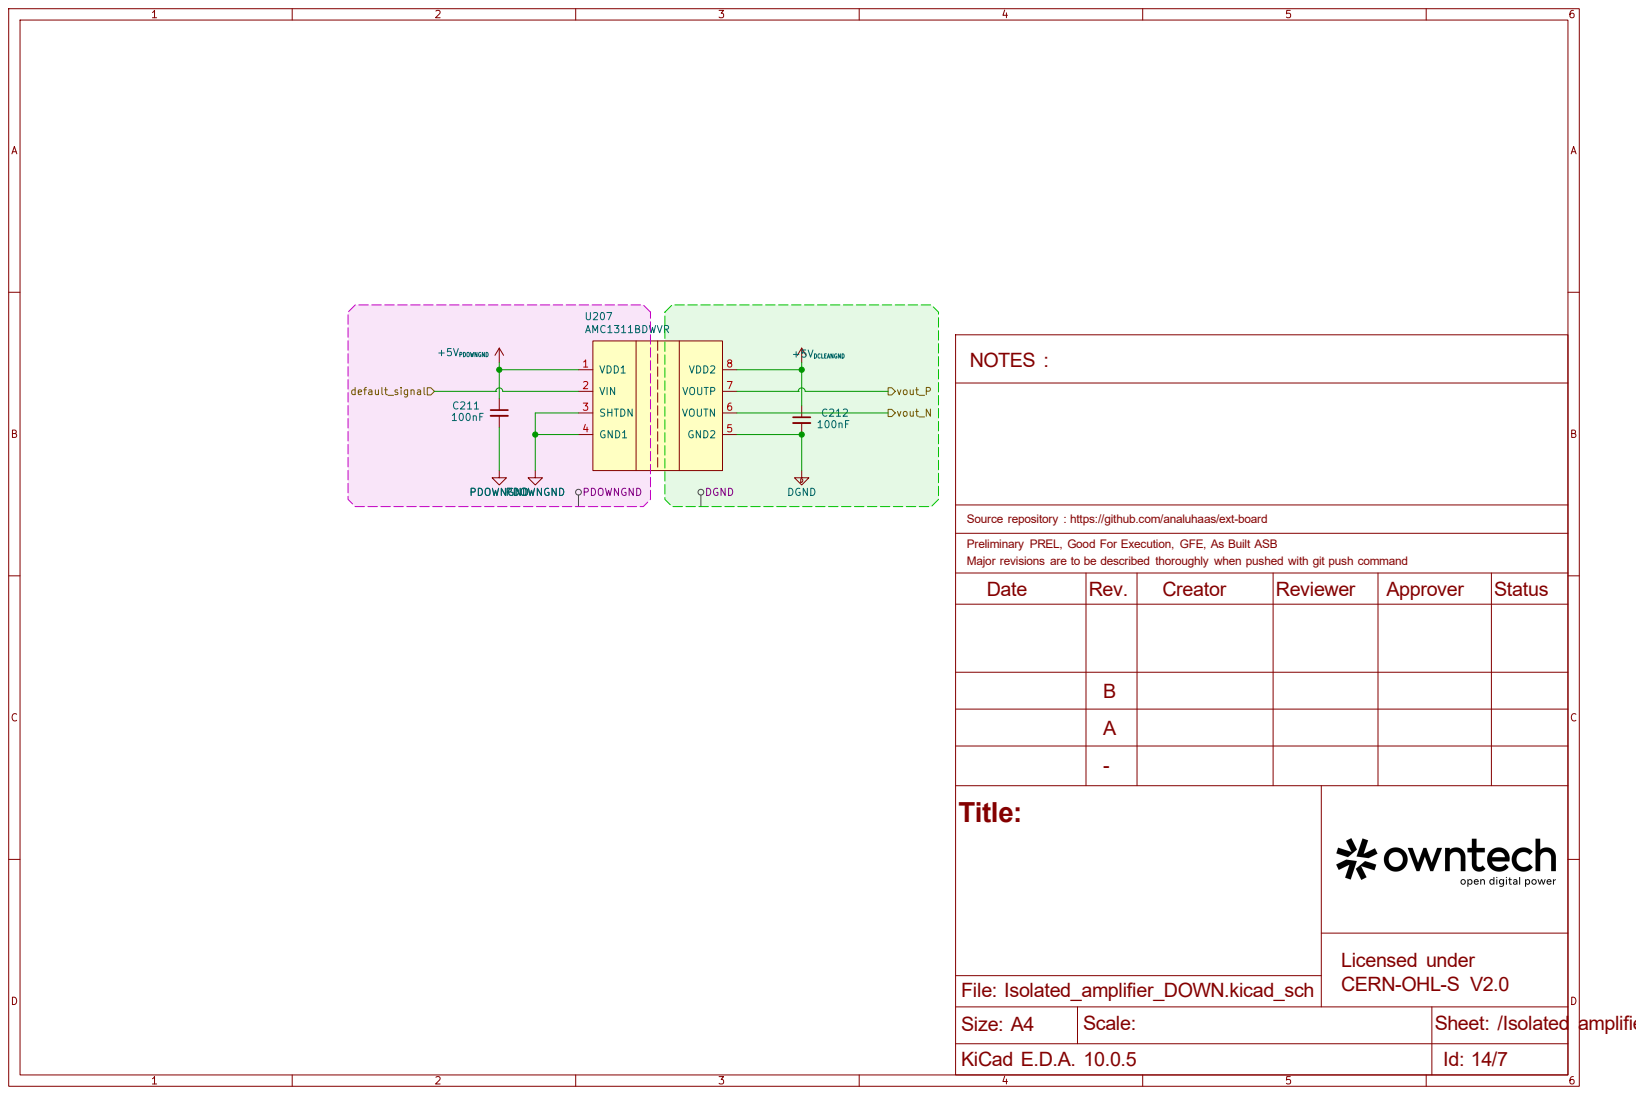
[picture p31: page 5]

Source repository : https://github.com/analuhaas/ext-board

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

Title:

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

Title:


Source repository : https://github.com/analuhaas/ext-board R257

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

Title:
