analuhaas/ext-board/ext_board.kicad_pcb

## KiCad design ext_board.kicad_pcb (2026-08-27)

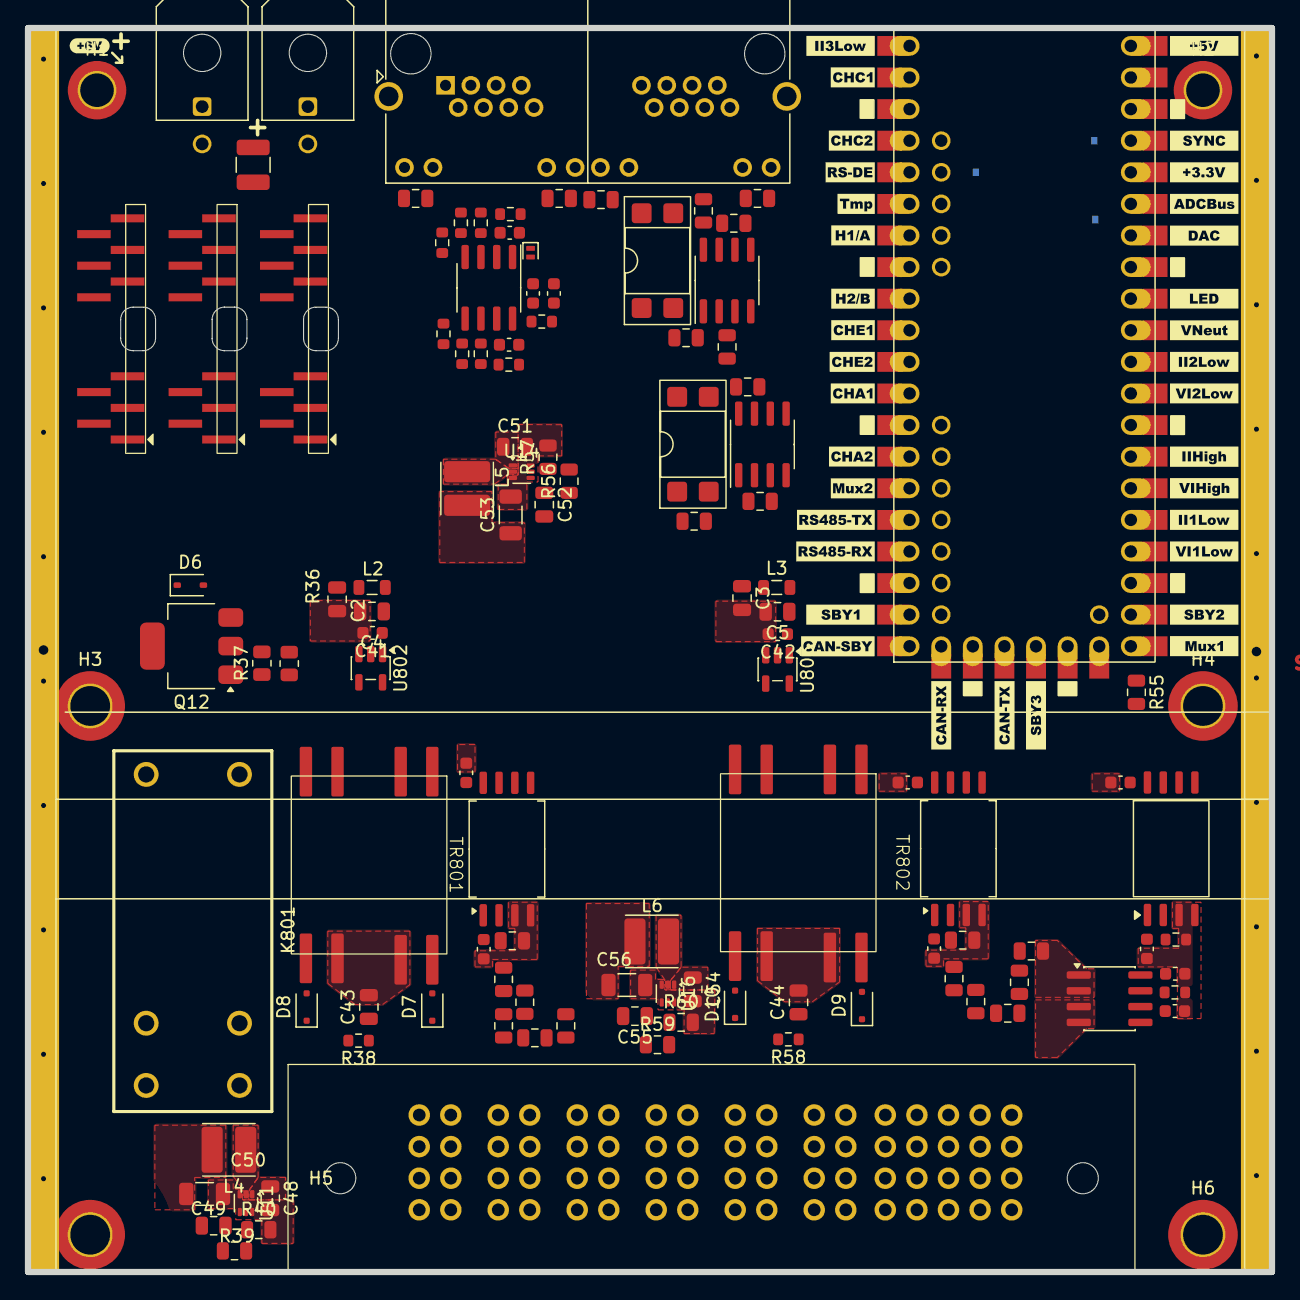
[picture p32: board ext_board.kicad_pcb from above]

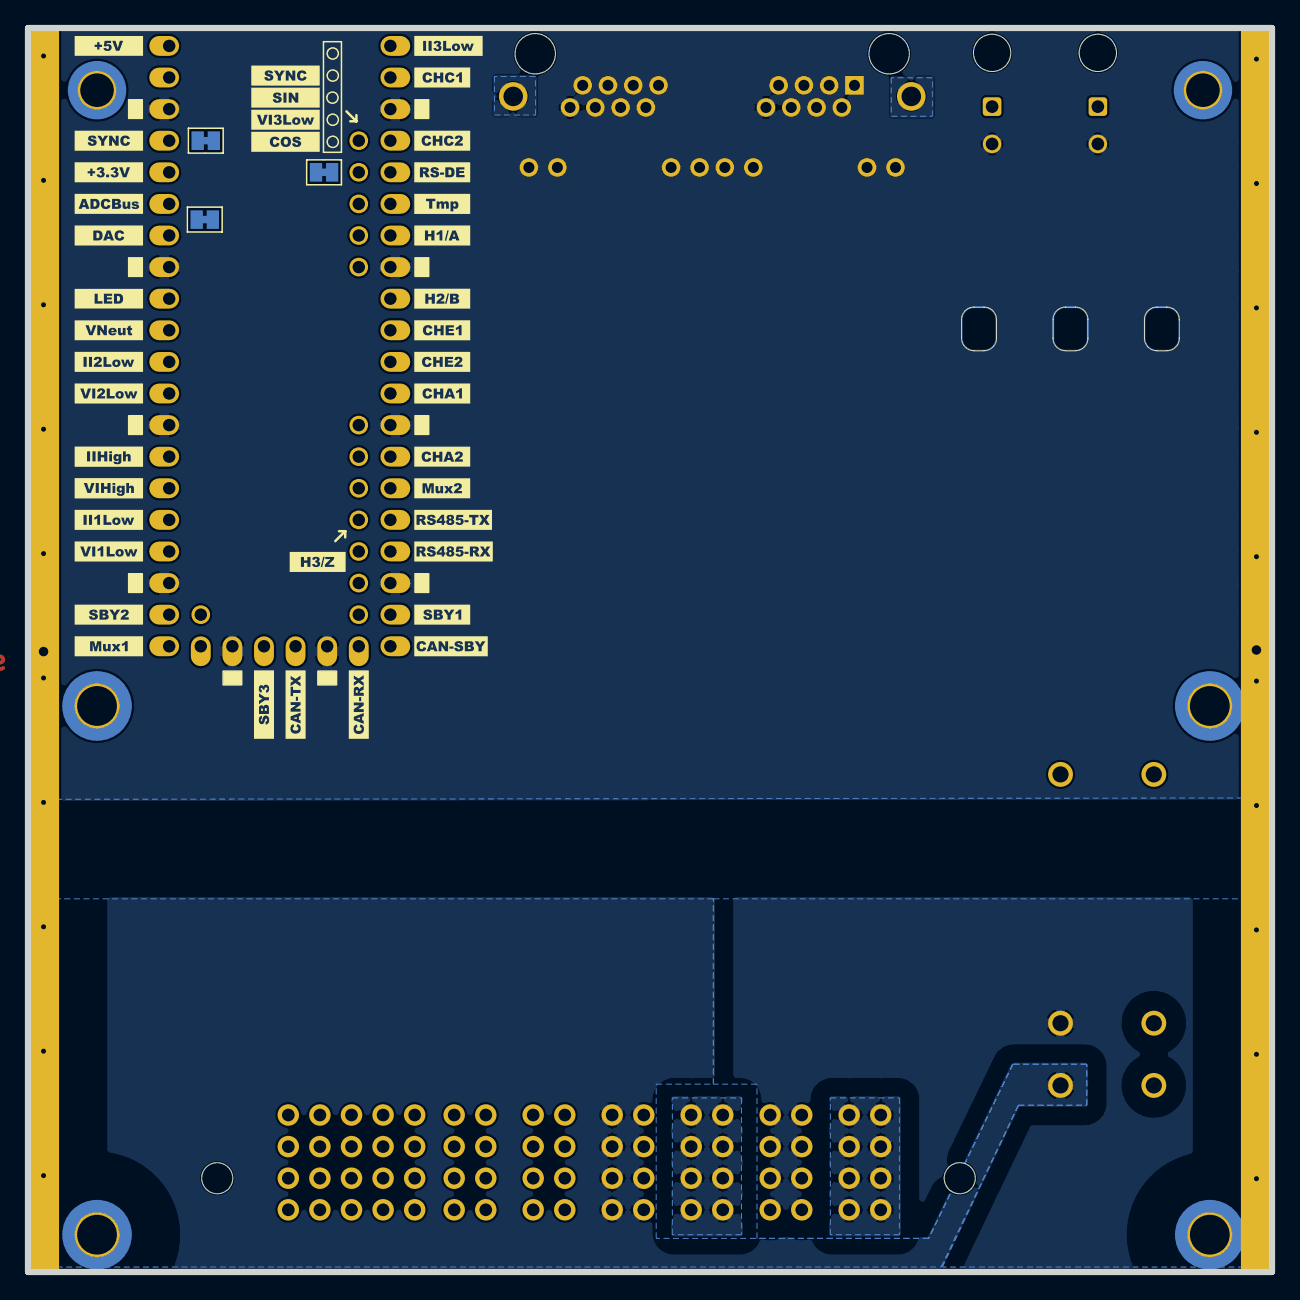
[picture p33: board ext_board.kicad_pcb from below]

Board: 4 copper layers, 100.0 x 100.0 mm, 197 parts (43 on the bottom side), 92 nets, no tracks yet.

Parts:
AFE801, AFE802, AFE807: AFE
C2, C3, C4, C5, C43, C44, C48, C51, C54: 10uF; C_0805_2012Metric
C41, C42, C205, C206, C211, C212, C233, C234, C413, C492: 100nF; C_0603_1608Metric
C49, C52, C55, C401, C410: 100nF; C_0805_2012Metric
C50, C53, C56: 47uF; C_1206_3216Metric
C411, C412: 20pF; C_0603_1608Metric
C470: 10nF; C_0603_1608Metric
C493: TODO; C_0603_1608Metric
D6: 40V - BAT165E6327F; D_SOD-323
D7, D8, D9, D10: PMEG3010; D_SOD-323F
D403: PMEG3010CEJ,115; D_SOD-882
F402: 350mA; Fuse_1210_3225Metric
H1, H2: M2.5; MountingHole_2.7mm_M2.5_DIN965_Pad_TopBottom
H3, H4, H5, H6: M3x3.5; MountingHole_3.2mm_M3_DIN965_Pad_TopBottom
J405, J406: Conn_01x02_Male; Molex_Micro-Fit_3.0_43045-0200_2x01_P3.00mm_Horizontal
J813: RJ45_LED_Shielded_x2; RJ45_Amphenol_RJHSE538X-02
JP406, JP410, JP417: Jumper_2_Bridged; SolderJumper-2_P1.3mm_Bridged_Pad1.0x1.5mm
K801: HF140FF/012-2HSWTF; RELAY-TH_HF140FF-024-2HSWT
L2, L3: 10uH; L_0805_2012Metric
L4, L5, L6: 4.7uH - 80mR; L_Cenker_CKCS4020
N101: Eurocard rails; Guard_ring
Q12: ZXMN7A11GTA; SOT-223
R36: 47R; R_0805_2012Metric
R37, R40, R57, R60: 10k; R_0805_2012Metric
R38, R58, R413, R414, R415, R416, R417, R418, R419, R428: 4.7k; R_0603_1608Metric
R39, R56, R59: 56k; R_0805_2012Metric
R55, R401, R406, R407, R410: 120R; R_0805_2012Metric
R249, R254: 5.6k; R_0805_2012Metric
R250, R251, R252, R255, R256, R257, R269, R270, R277, R278: 330k; R_0805_2012Metric
R280, R281: TODO; R_0603_1608Metric
R402, R404: 330R; R_0805_2012Metric
R403, R405: 3k; R_0805_2012Metric
R412: 4.7k; R_0805_2012Metric
R470: 120R; R_0603_1608Metric
TR801, TR802: CMT88; CMT88F0U
U11, U14, U16: TPS562202; SOT-563
U205, U207, U211: AMC1311BDWVR; SOIC-8_7.5x5.85mm_P1.27mm
U401: OwnTech_SPIN; OwnTech_SPINTHT_1
U402: TCAN334GDR; SOIC-8_3.9x4.9mm_P1.27mm
U405: SOIC-8_3.9x4.9mm_P1.27mm
U406: MCP6487T-E/SN; SOIC-8_3.9x4.9mm_P1.27mm
U801: ACS724xLCTR-50AB; SOIC-8_3.9x4.9mm_P1.27mm
U802, U803: SOT-23-5
U809: PwrBlade51722-106020
U820, U821: ASSR-1218; DIP-4_W7.62mm_SMDSocket_SmallPads
kibuzzard-68EE2A82: G***; kibuzzard-68EE2A82
kibuzzard-68EE3B36: G***; kibuzzard-68EE3B36
kibuzzard-68EE4C07: G***; kibuzzard-68EE4C07
kibuzzard-68EE24A5: G***; kibuzzard-68EE24A5
kibuzzard-68EE24AF: G***; kibuzzard-68EE24AF
kibuzzard-68EE24B5: G***; kibuzzard-68EE24B5
kibuzzard-68EE24BE: G***; kibuzzard-68EE24BE
kibuzzard-68EE24D4: G***; kibuzzard-68EE24D4
kibuzzard-68EE24E5: G***; kibuzzard-68EE24E5
kibuzzard-68EE24F3: G***; kibuzzard-68EE24F3
kibuzzard-68EE25AA: G***; kibuzzard-68EE25AA
kibuzzard-68EE25BE: G***; kibuzzard-68EE25BE
kibuzzard-68EE25CD: G***; kibuzzard-68EE25CD
kibuzzard-68EE43ED: G***; kibuzzard-68EE43ED
kibuzzard-68EE43F5: G***; kibuzzard-68EE43F5
kibuzzard-68EE44CF: G***; kibuzzard-68EE44CF
kibuzzard-68EE44DF: G***; kibuzzard-68EE44DF
kibuzzard-68EE44EF: G***; kibuzzard-68EE44EF
kibuzzard-68EE45B1: G***; kibuzzard-68EE45B1
kibuzzard-68EE45BE: G***; kibuzzard-68EE45BE
kibuzzard-68EE45CB: G***; kibuzzard-68EE45CB
kibuzzard-68EE45EE: G***; kibuzzard-68EE45EE
kibuzzard-68EE46AF: G***; kibuzzard-68EE46AF
kibuzzard-68EE46C1: G***; kibuzzard-68EE46C1
kibuzzard-68EE46D0: G***; kibuzzard-68EE46D0
kibuzzard-68EE46DF: G***; kibuzzard-68EE46DF
kibuzzard-68EE46EE: G***; kibuzzard-68EE46EE
kibuzzard-68EE46FA: G***; kibuzzard-68EE46FA
kibuzzard-68EE47A2: G***; kibuzzard-68EE47A2
kibuzzard-68EE47C7: G***; kibuzzard-68EE47C7
kibuzzard-68EE47E7: G***; kibuzzard-68EE47E7
kibuzzard-68EE71D6: G***; kibuzzard-68EE71D6
kibuzzard-68EE71F4: G***; kibuzzard-68EE71F4
kibuzzard-68EE71FA: G***; kibuzzard-68EE71FA
kibuzzard-68EE241F: G***; kibuzzard-68EE241F
kibuzzard-68EE244B: G***; kibuzzard-68EE244B
kibuzzard-68EE255F: G***; kibuzzard-68EE255F
kibuzzard-68EE260A: G***; kibuzzard-68EE260A
kibuzzard-68EE263D: G***; kibuzzard-68EE263D
kibuzzard-68EE264C: G***; kibuzzard-68EE264C
kibuzzard-68EE450D: G***; kibuzzard-68EE450D
kibuzzard-68EE470A: G***; kibuzzard-68EE470A
kibuzzard-68EE477F: G***; kibuzzard-68EE477F
kibuzzard-68EE721A: G***; kibuzzard-68EE721A
kibuzzard-68EE2327: G***; kibuzzard-68EE2327
kibuzzard-68EE2338: G***; kibuzzard-68EE2338
kibuzzard-68EE2344: G***; kibuzzard-68EE2344
kibuzzard-68EE2352: G***; kibuzzard-68EE2352
kibuzzard-68EE2407: G***; kibuzzard-68EE2407
kibuzzard-68EE2434: G***; kibuzzard-68EE2434
kibuzzard-68EE2472: G***; kibuzzard-68EE2472
kibuzzard-68EE2482: G***; kibuzzard-68EE2482
kibuzzard-68EE2491: G***; kibuzzard-68EE2491
kibuzzard-68EE2506: G***; kibuzzard-68EE2506
kibuzzard-68EE2514: G***; kibuzzard-68EE2514
kibuzzard-68EE2525: G***; kibuzzard-68EE2525
kibuzzard-68EE2547: G***; kibuzzard-68EE2547
kibuzzard-68EE2570: G***; kibuzzard-68EE2570
kibuzzard-68EE2583: G***; kibuzzard-68EE2583
kibuzzard-68EE2597: G***; kibuzzard-68EE2597
kibuzzard-68EE2618: G***; kibuzzard-68EE2618
kibuzzard-68EE2628: G***; kibuzzard-68EE2628
kibuzzard-68EE4414: G***; kibuzzard-68EE4414
kibuzzard-68EE4445: G***; kibuzzard-68EE4445
kibuzzard-68EE4488: G***; kibuzzard-68EE4488
kibuzzard-68EE4573: G***; kibuzzard-68EE4573
kibuzzard-68EE4580: G***; kibuzzard-68EE4580
kibuzzard-68EE4598: G***; kibuzzard-68EE4598
kibuzzard-68EE4753: G***; kibuzzard-68EE4753
kibuzzard-68EE4764: G***; kibuzzard-68EE4764
kibuzzard-68EE4773: G***; kibuzzard-68EE4773
kibuzzard-68EE4806: G***; kibuzzard-68EE4806
kibuzzard-68EE4815: G***; kibuzzard-68EE4815
kibuzzard-68EE4829: G***; kibuzzard-68EE4829
kibuzzard-68EE7214: G***; kibuzzard-68EE7214

Connections:
+5V_{DGND}: AFE801.1 (+5V), AFE801.9 (A0), AFE802.1 (+5V), AFE807.1 (+5V), AFE807.11 (A2), C53.1, C206.1, C212.1, C234.1, C401.1, C410.1, C413.1, L5.2, R56.1, U205.8 (VDD2), U207.8 (VDD2), U211.8 (VDD2), U401.40 (+VIN), U402.3 (VCC), U405.8 (VCC), U406.8 (V+)
+5V_{PDOWNGND}: C56.1, C211.1, C233.1, C492.2, L6.2, R59.1, U207.1 (VDD1), U211.1 (VDD1), U801.8 (VCC)
+5V_{PUPGND}: C50.1, C205.1, L4.2, R39.1, U205.1 (VDD1)
+12V_{DGND}: C2.1, C3.1, C51.1, D6.1 (K), F402.2, K801.8, L2.1, L3.1, U14.1 (VIN), U14.5 (EN)
+12V_{PDOWNGND}: C44.1, C54.1, D9.1 (K), D10.1 (K), R58.1, U16.1 (VIN), U16.5 (EN)
+12V_{PUPGND}: C43.1, C48.1, D7.1 (K), D8.1 (K), R38.1, U11.1 (VIN), U11.5 (EN)
/Current sensor/I+: K801.3, R277.1, U801.1 (IP+), U801.2 (IP+)
/Current sensor/Iout_N: AFE807.3 (IN-), U211.6 (VOUTN)
/Current sensor/Iout_P: AFE807.2 (IN+), U211.7 (VOUTP)
/Isolated amplifier DOWN/vout_N: AFE802.3 (IN-), U207.6 (VOUTN)
/Isolated amplifier DOWN/vout_P: AFE802.2 (IN+), U207.7 (VOUTP)
/Isolated amplifier UP/vout_N: AFE801.3 (IN-), U205.6 (VOUTN)
/Isolated amplifier UP/vout_P: AFE801.2 (IN+), U205.7 (VOUTP)
/MCU/A: J813.3, J813.15, R410.1, U405.6 (A)
/MCU/ADC2_IN5: C470.1, R470.1, U401.35 (PC4)
/MCU/B: J813.6, J813.18, U405.7 (B), U820.3
/MCU/CAN_H: J813.1, J813.13, U402.7 (CANH), U821.4
/MCU/CAN_L: J813.2, J813.14, R401.2, U402.6 (CANL)
/MCU/DAC2: JP417.1 (A), U401.34 (PA6)
/MCU/FDCAN2_{RX}: U401.53 (PB5), U402.4 (RXD)
/MCU/FDCAN2_{TX}: U401.55 (PB6), U402.1 (TXD)
/MCU/HRTIM1_SCIN: J813.7, J813.19, JP406.2 (B), JP410.2 (B)
/MCU/PB1: JP406.1 (A), U401.37 (PB1)
/MCU/PB2: JP410.1 (A), U401.42 (PB2)
/MCU/PC13: R55.1, U401.22 (PC13)
/MCU/SHARE+: C412.2, D403.1 (K), J813.5, J813.17, R416.2, R419.2
/MCU/SHARE-: J813.4, J813.16, R417.2, R418.2
/MCU/TERM120: J813.12, U820.1, U821.1
/MCU/USART3_DE: R412.1, U401.5 (PB14), U405.2 (~RE), U405.3 (DE)
/MCU/USART3_RX: U401.17 (PC11), U405.1 (RO)
/MCU/USART3_TX: U401.16 (PC10), U405.4 (DI)
/Relay: R36.1, R55.2
/SCL_{MCU}: AFE801.6 (SCL), AFE802.6 (SCL), AFE807.6 (SCL), U401.46 (PA13)
/SDA_{MCU}: AFE801.7 (SDA), AFE802.7 (SDA), AFE807.7 (SDA), U401.47 (PA14)
/V1DOWN_{MCU}: AFE802.4 (OUT), U401.29 (PA0)
/V1DOWN_{RAW}: R249.1, R252.2, U207.2 (VIN)
/V1UP_{MCU}: AFE801.4 (OUT), U401.24 (PC0)
/V1UP_{RAW}: R254.1, R257.2, U205.2 (VIN)
/V_{DOWN}: U801.3 (IP-), U801.4 (IP-), U809.3
/V_{UP}: K801.4, R278.1, U809.1
DGND: AFE801.5 (GND), AFE801.10 (A1), AFE801.11 (A2), AFE802.5 (GND), AFE802.9 (A0), AFE802.10 (A1), AFE802.11 (A2), AFE807.5 (GND), AFE807.9 (A0), AFE807.10 (A1), C2.2, C3.2, C4.2, C5.2, C41.2, C42.2, C51.2, C53.2, C206.2, C212.2, C234.2, C401.2, C410.2, C413.2, C470.2, J405.2, J406.2, J813.8, J813.20, Q12.3 (S), R37.2, R57.2, R402.1, R403.1, R404.1, R405.1, R406.2, R407.2, R412.2, R414.1, R428.1, U14.3 (GND), U205.5 (GND2), U207.5 (GND2), U211.5 (GND2), U401.3 (GND), U401.8 (GND), U401.13 (GND), U401.18 (GND), U401.23 (GND), U401.28 (GND), U401.33 (GND), U401.38 (GND), U401.54 (GND), U401.57 (GND), U402.2 (GND), U405.5 (GND), U406.4 (V-), U802.2 (GND), U803.2 (GND)
Earth_Protective: H1.1 (1_1), H2.1 (1_1), H3.1 (1_1), H4.1 (1_1), H5.1 (1_1), H6.1 (1_1), J813.SH, N101.1 (PAD_1)
unnamed: C411.1, R415.1, R470.2, U406.7
unnamed: D6.2 (A), K801.1, Q12.2 (D), Q12.4 (D)
unnamed: D7.2 (A), TR801.8 (SB)
unnamed: D8.2 (A), TR801.5 (SA)
unnamed: D9.2 (A), TR802.8 (SB)
unnamed: D10.2 (A), TR802.5 (SA)
unnamed: D403.2 (A), U406.1
unnamed: F402.1, J405.1, J406.1
unnamed: J813.9, R403.2
unnamed: J813.11, R402.2
unnamed: J813.21, R405.2
unnamed: J813.23, R404.2
unnamed: JP417.2 (B), R413.1
unnamed: Q12.1 (G), R36.2, R37.1
unnamed: R250.1, R269.2
unnamed: R250.2, R251.1
unnamed: R251.2, R252.1
unnamed: R255.1, R270.2
unnamed: R255.2, R256.1
unnamed: R256.2, R257.1
unnamed: R269.1, R277.2
unnamed: R270.1, R278.2
unnamed: R401.1, U821.3
unnamed: R406.1, U821.2
unnamed: R407.1, U820.2
unnamed: R410.2, U820.4
unnamed: C49.2, L4.1, U11.2 (SW)
unnamed: C49.1, U11.4 (VBST)
unnamed: R39.2, R40.1, U11.6 (VFB)
unnamed: C52.2, L5.1, U14.2 (SW)
unnamed: C52.1, U14.4 (VBST)
unnamed: R56.2, R57.1, U14.6 (VFB)
unnamed: C55.2, L6.1, U16.2 (SW)
unnamed: C55.1, U16.4 (VBST)
unnamed: R59.2, R60.1, U16.6 (VFB)
unnamed: R280.2, R281.1, U211.2 (VIN)
unnamed: R413.2, R417.1, U406.3 (+)
unnamed: C412.1, R414.2, R416.1, U406.2 (-)
unnamed: R419.1, R428.2, U406.5 (+)
unnamed: C411.2, R415.2, R418.1, U406.6 (-)
unnamed: C493.2, U801.6 (FILTER)
unnamed: R280.1, U801.7 (VIOUT)
unnamed: C4.1, C41.1, L2.2, U802.1 (VDD), U802.3 (SEL)
unnamed: TR801.1 (AA), TR801.2 (AA), U802.5 (VB1)
unnamed: TR801.3 (AB), TR801.4 (AB), U802.4 (VB2)
unnamed: C5.1, C42.1, L3.2, U803.1 (VDD), U803.3 (SEL)
unnamed: TR802.1 (AA), TR802.2 (AA), U803.5 (VB1)
unnamed: TR802.3 (AB), TR802.4 (AB), U803.4 (VB2)
PDOWNGND: C44.2, C54.2, C56.2, C211.2, C233.2, C492.1, C493.1, K801.5, R58.2, R60.2, R249.2, R281.2, TR802.6 (SB), TR802.7 (SA), U16.3 (GND), U207.3 (SHTDN), U207.4 (GND1), U211.3 (SHTDN), U211.4 (GND1), U801.5 (GND), U809.4
PUPGND: C43.2, C48.2, C50.2, C205.2, K801.6, R38.2, R40.2, R254.2, TR801.6 (SB), TR801.7 (SA), U11.3 (GND), U205.3 (SHTDN), U205.4 (GND1), U809.2
