analuhaas/ext-board/(commit log)

2026-08-12 First schematic version
    [AFE.kicad_sch, AFE_BLOCK.kicad_sch, Feeder.kicad_sch, Hall_Sensor.kicad_sch, High_side.kicad_sch, InverterLeg.kicad_sch, Isolated_amplifier.kicad_sch, Isolated_amplifier_DOWN.kicad_sch]
2026-08-12 Board schematic first version with cleaner repository
    [AFE.kicad_sch, AFE_BLOCK.kicad_sch, Feeder.kicad_sch, Hall_Sensor.kicad_sch, High_side.kicad_sch, InverterLeg.kicad_sch, Isolated_amplifier.kicad_sch, Isolated_amplifier_DOWN.kicad_sch]
2026-08-13 First version of the board layout without wiring
    [Microcontroller.kicad_sch, Resistive_bridge.kicad_sch, current_sensor.kicad_sch, ext_board.kicad_sch]
2026-08-14 Second version of board layout: isolation in line and other adaptations to enable mechanical implementation of the protection box for user safety
    [Microcontroller.kicad_sch, ext_board.kicad_pcb, ext_board.kicad_sch]
2026-08-27 Second version of the board with some naming corrections
2026-09-04 Updated layout relay position
2026-09-04 Schematic change on the 5 VDGND, 5VPUPGND and 5VPDOWNGND generation with a linear regulator. Layout change to have rectangular protection box and bring closer the current sensor to the relay to avoid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
2026-09-21 V1 of +5V and +12V feeding wiring. Used In1 in order to be in different layer from signals
2026-09-21 Added README with board development details
2026-10-20 Added wiring without setting up the wires width and height
2026-10-26 Second version of wiring: need to validate the width of the wires, planes positioning and see how to put impedence between PUGND and PDOWNGND
2026-10-27 3rd version of the PCB wiring, still nedd to add adapted resistor between the grounds
2026-11-05 4th version of PCB
2026-11-06 Version 5 of PCB: updated README and solved some DRC issues
